ccc909/Whistler/docs/mic-array-bottom.png

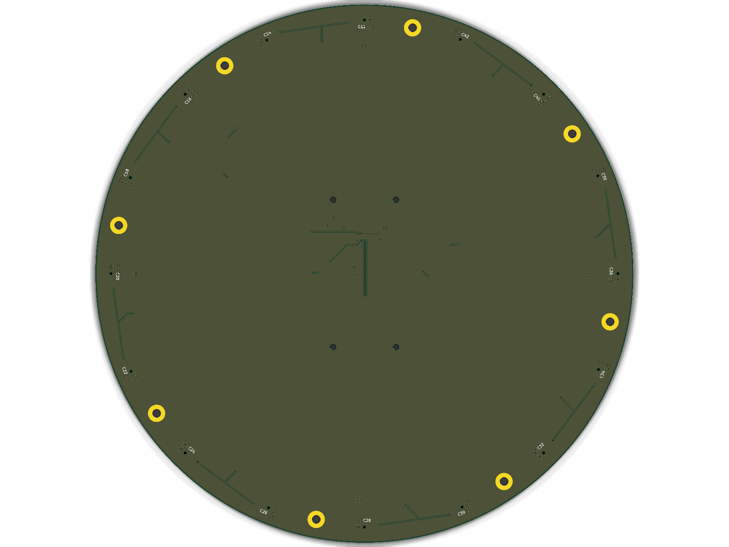
docs/mic-array-bottom.png
