ccc909/Whistler/mic-array/production/whistler-mic-array-bom.csv

Comment | Designator | Footprint | LCSC | Quantity | Manufacturer | MPN | Description
100nF | C1,C12,C14,C16,C18,C20,C22,C24,C26,C28,C30,C32,C34,C36,C38,C40,C42 | C_0402_1005Metric | C1525 | 17 |  |  | Unpolarized capacitor, small symbol
1uF | C2,C3,C4,C11,C13,C15,C17,C19,C21,C23,C25,C27,C29,C31,C33,C35,C37,C39,C41 | C_0402_1005Metric | C14445 | 19 |  |  | Unpolarized capacitor, small symbol
10uF | C5 | C_0603_1608Metric | C18800 | 1 |  |  | Unpolarized capacitor
4.7uF | C6,C7,C8,C9 | C_0603_1608Metric | C1705 | 4 |  |  | Unpolarized capacitor
LED | D2 | LED_0603_1608Metric | C12624 | 1 |  |  | Light emitting diode
680R | FB11 | C_0402_1005Metric | C96691 | 1 |  |  | Ferrite bead, small symbol
Conn_01x24 | J19 | Hirose_FH12-24S-0.5SH_1x24-1MP_P0.50mm_Horizontal | C202112 | 1 |  |  | Generic connector, single row, 01x24, script generated (kicad-library-utils/schlib/autogen/connector/)
IM72D128V01XTMA1 | MK1,MK2,MK3,MK4,MK5,MK6,MK7,MK8,MK9,MK10,MK11,MK12,MK13,MK14,MK15,MK16 | MIC_IM72D128V01XTMA1 | C5119248 | 16 | Infineon Technologies | IM72D128 | 20 Hz ~ 19 kHz Digital, PDM Microphone MEMS (Silicon) 1.62 V ~ 3.6 V Omnidirectional (-36dB ±1dB @ 94dB SPL) Solder Pads
22R | R1,R2,R3,R4 | R_0402_1005Metric | C25092 | 4 |  |  | Resistor, small symbol
470R | R5 | R_0402_1005Metric | C25117 | 1 |  |  | Resistor, small symbol
33R | R6,R7,R8,R9,R10,R11,R12,R13,R14,R15,R16,R17,R18,R19,R20,R21 | R_0402_1005Metric | C25105 | 16 |  |  | Resistor, small symbol
TPS7A2018PDBVR | U3 | SOT-23-5 | C963430 | 1 |  |  | 300 mA Low Dropout Voltage Regulator, Fixed Output, 1.6..6.0Vin, Low-Noise (7μV RMS), 6.5μA IQ LDO, SOT-23
74LVC125 | U6 | SOIC-14_3.9x8.7mm_P1.27mm | C6057 | 1 |  |  | Quad buffer 3-State outputs
