ccc909/Whistler/mic-array/production/whistler-mic-array.step

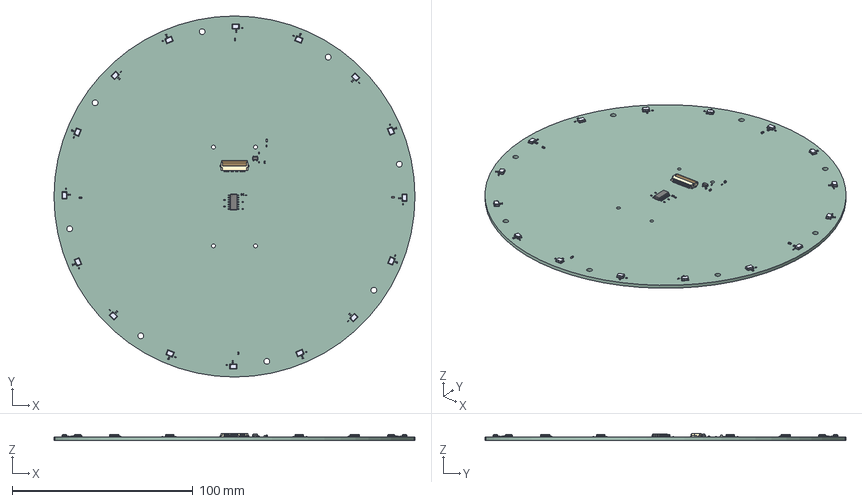
[picture p7: CAD file, 2026-10-23]
mic-array/production/whistler-mic-array.step
200.0 x 200.0 x 4.00 mm
R_0402_1005Metric x 21
IM72D128V01XTMA1 x 16
lock
pins
C_0402_1005Metric x 37
SOIC-14_3.9x8.7mm_P1.27mm
C_0603_1608Metric x 5
LED_0603_1608Metric
SOT-23-5
whistler-mic-array_PCB
