ccc909/Whistler/motherboard/production/whistler-motherboard.step

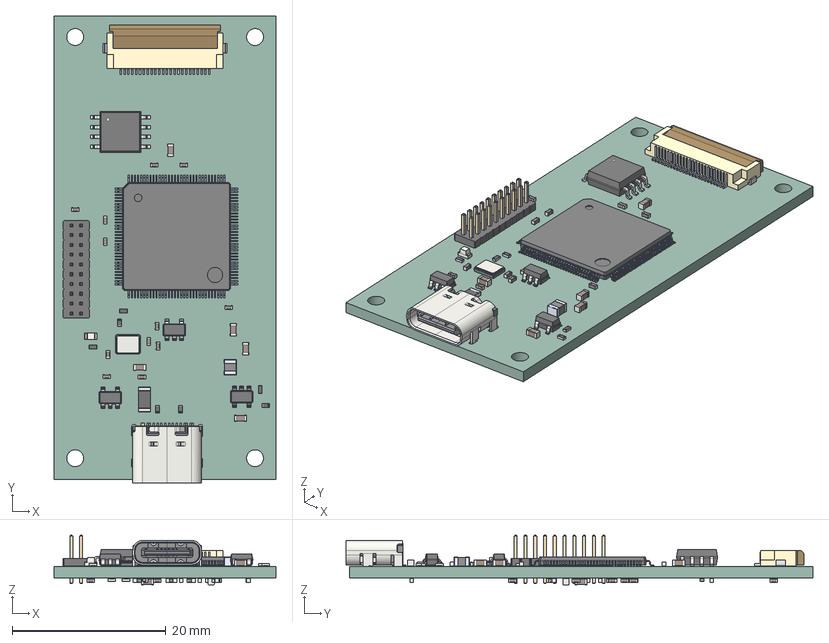
[picture p8: CAD file, 2026-10-23]
motherboard/production/whistler-motherboard.step
28.8 x 60.7 x 6.44 mm
C_0402_1005Metric x 36
R_0402_1005Metric x 10
DFE201612E-2R2M_P2
C_0603_1608Metric x 6
PinHeader_2x10_P1.27mm_Vertical
Fuse_1206_3216Metric
SOT-23-5 x 3
SOIC-8_5.3x5.3mm_P1.27mm
LED_0603_1608Metric
USB_C_Receptacle_GCT_USB4105-xx-A_16P_TopMnt_Horizontal
Body001 (Mirror #1) x 32
Body002 (Mirror #2) x 32
Crystal_SMD_3225-4Pin_3.2x2.5mm
lock
pins
L_0603_1608Metric
whistler-motherboard_PCB
