ccc909/Whistler/mic-array/production/whistler-mic-array-schematic.pdf

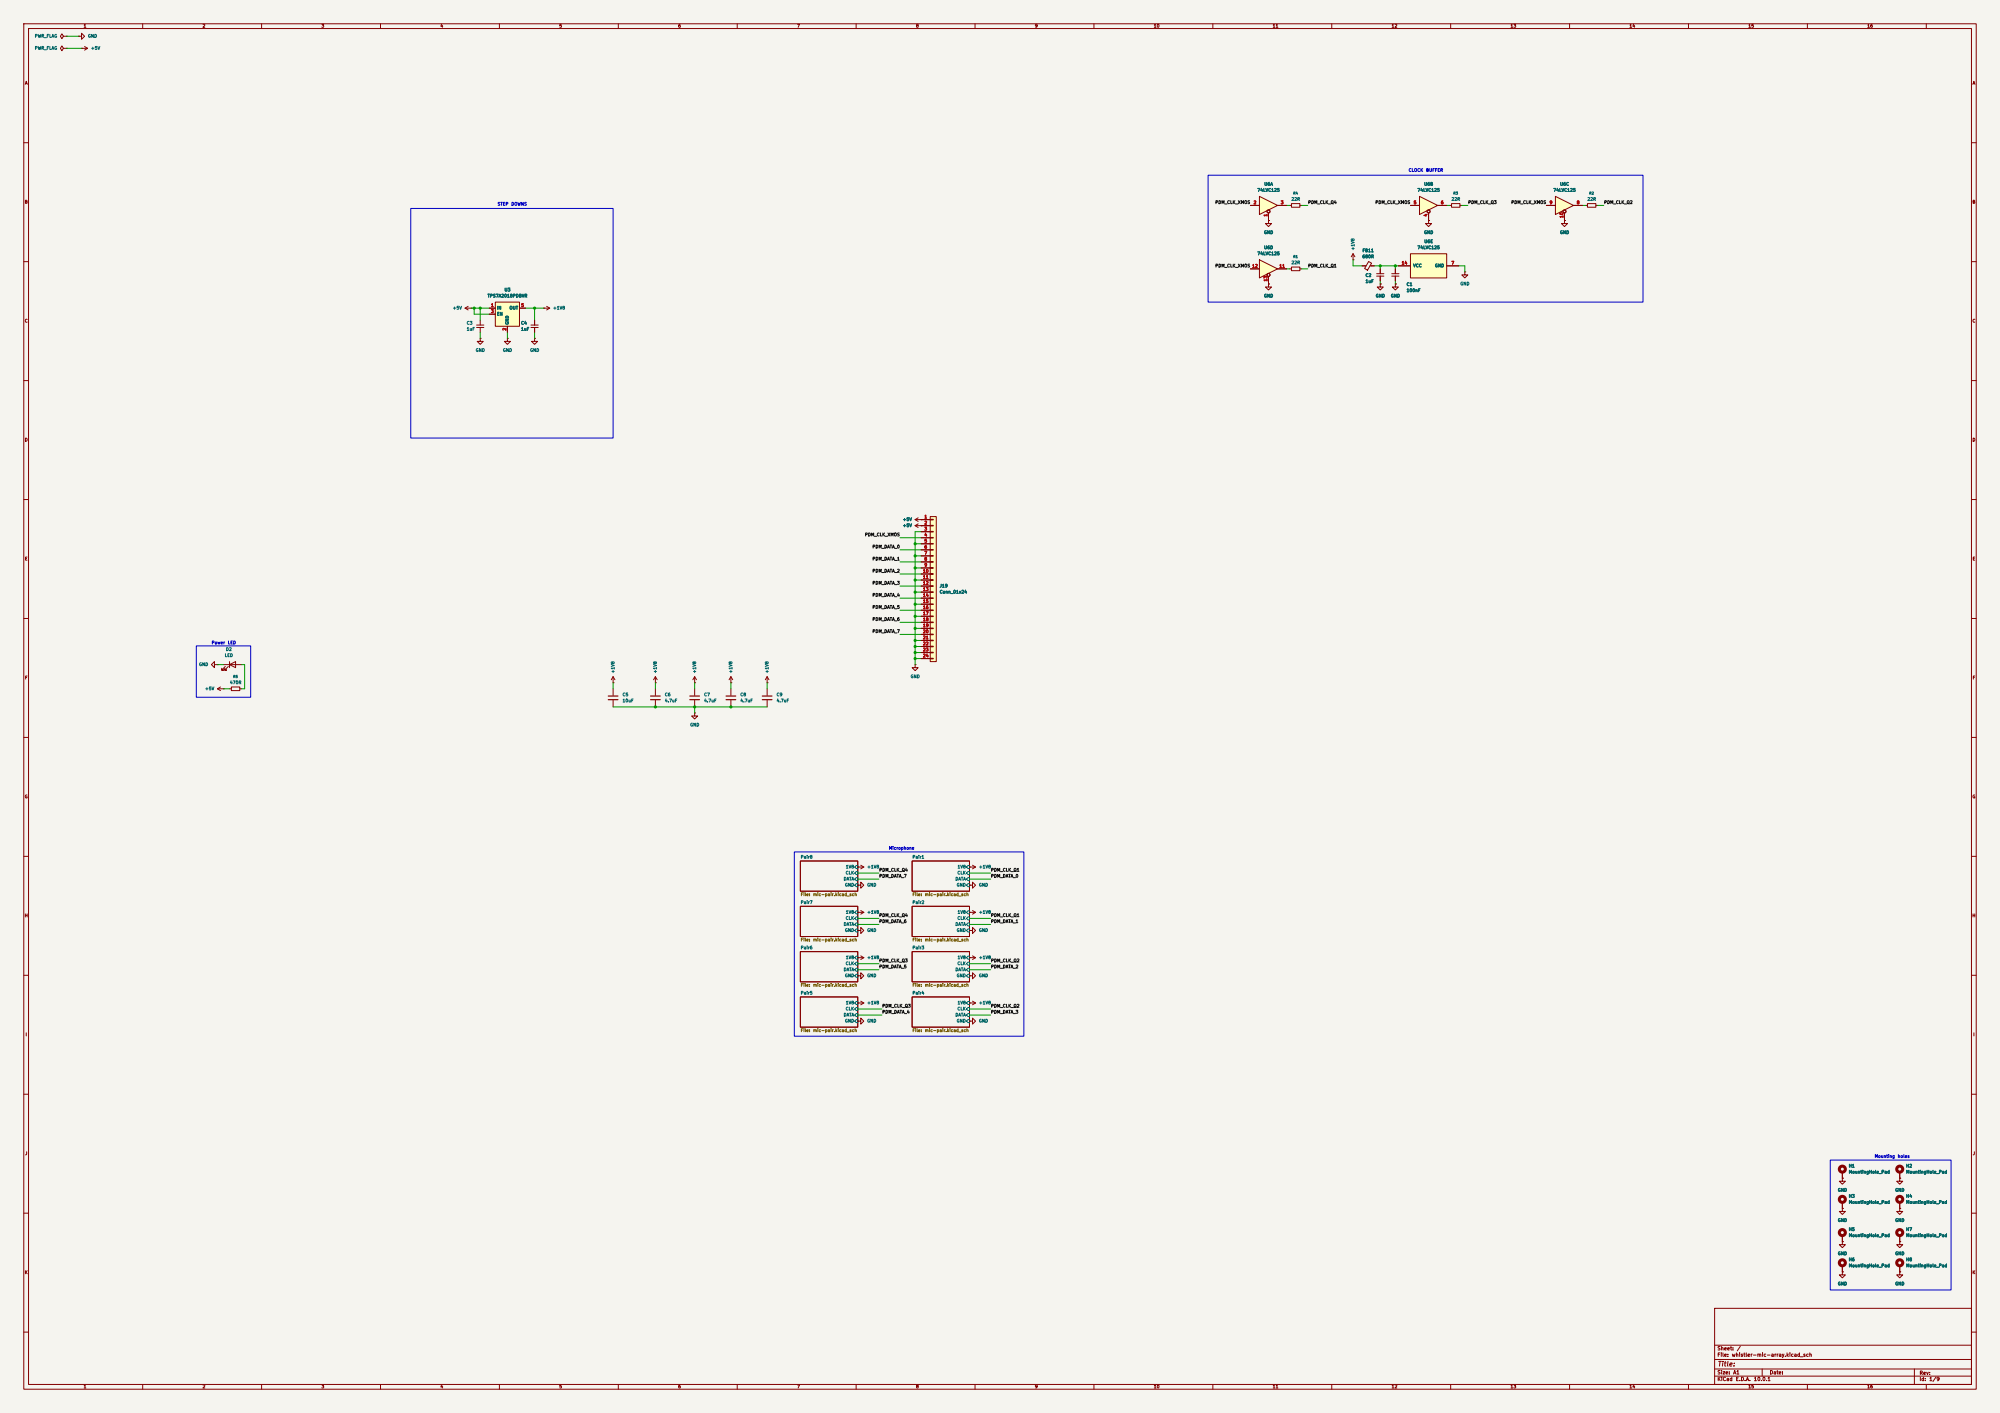
[picture p12: page 1]

File: mic-pair.kicad_sch 1V8 CLK

Pair2

Sheet: /
File: whistler-mic-array.kicad_sch
Title:

Size: A1 | Rev:
KiCad E.D.A. 10.0.1 | Id: 1/9

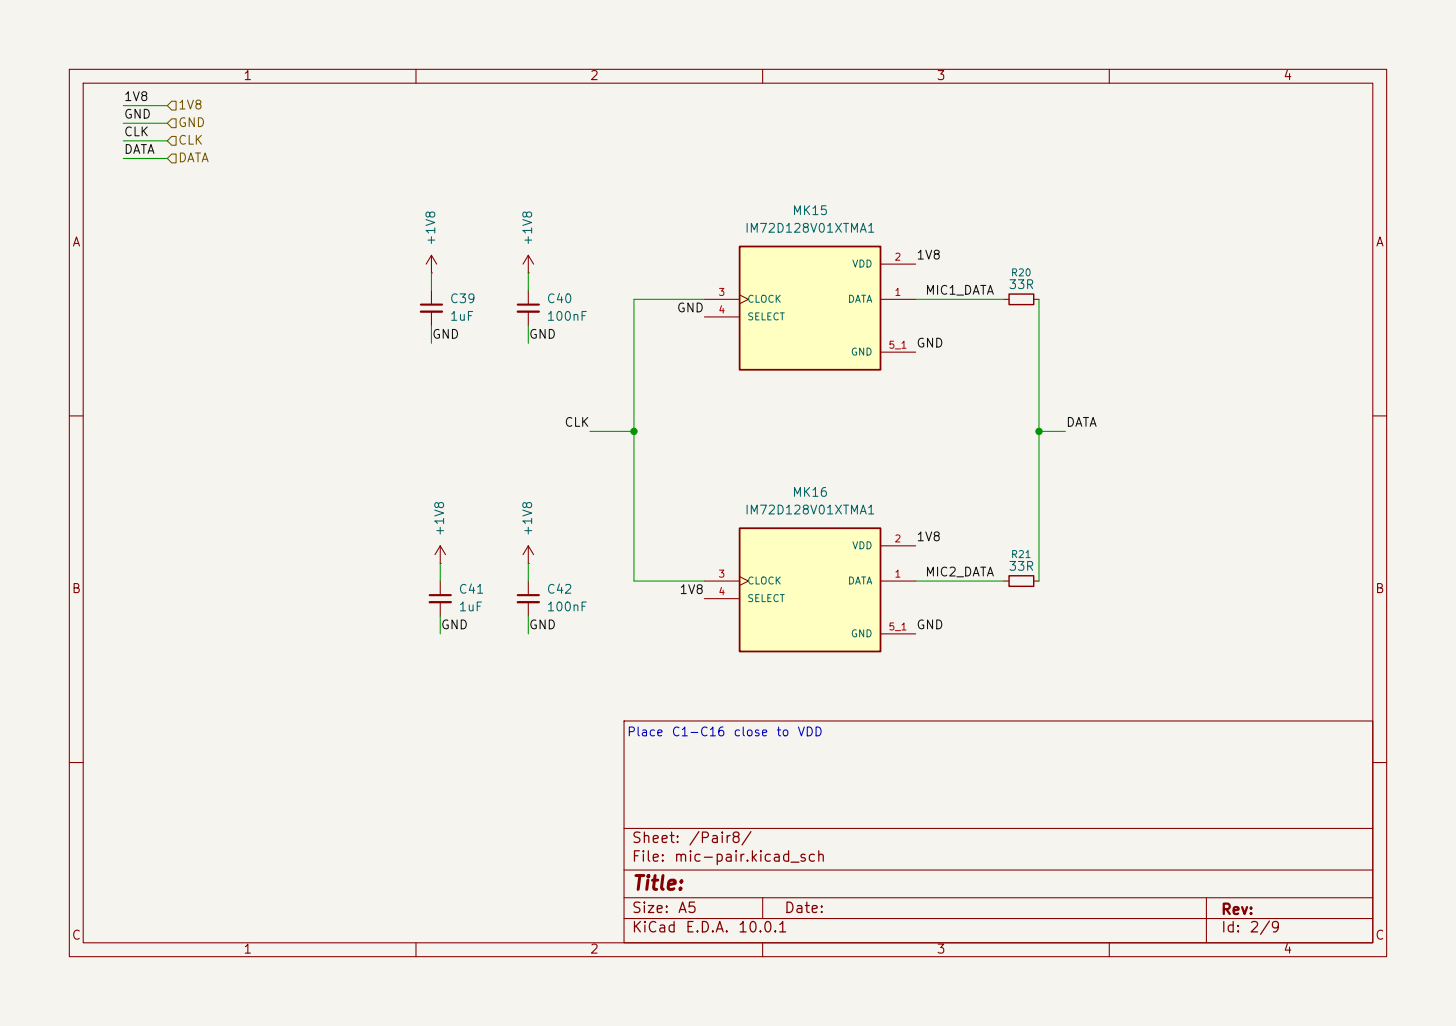
[picture p13: page 2]

1V8 Place C1-C16 close to VDD

Size: A5 | Rev: | C Date:
KiCad E.D.A. 10.0.1 | Id: 2/9

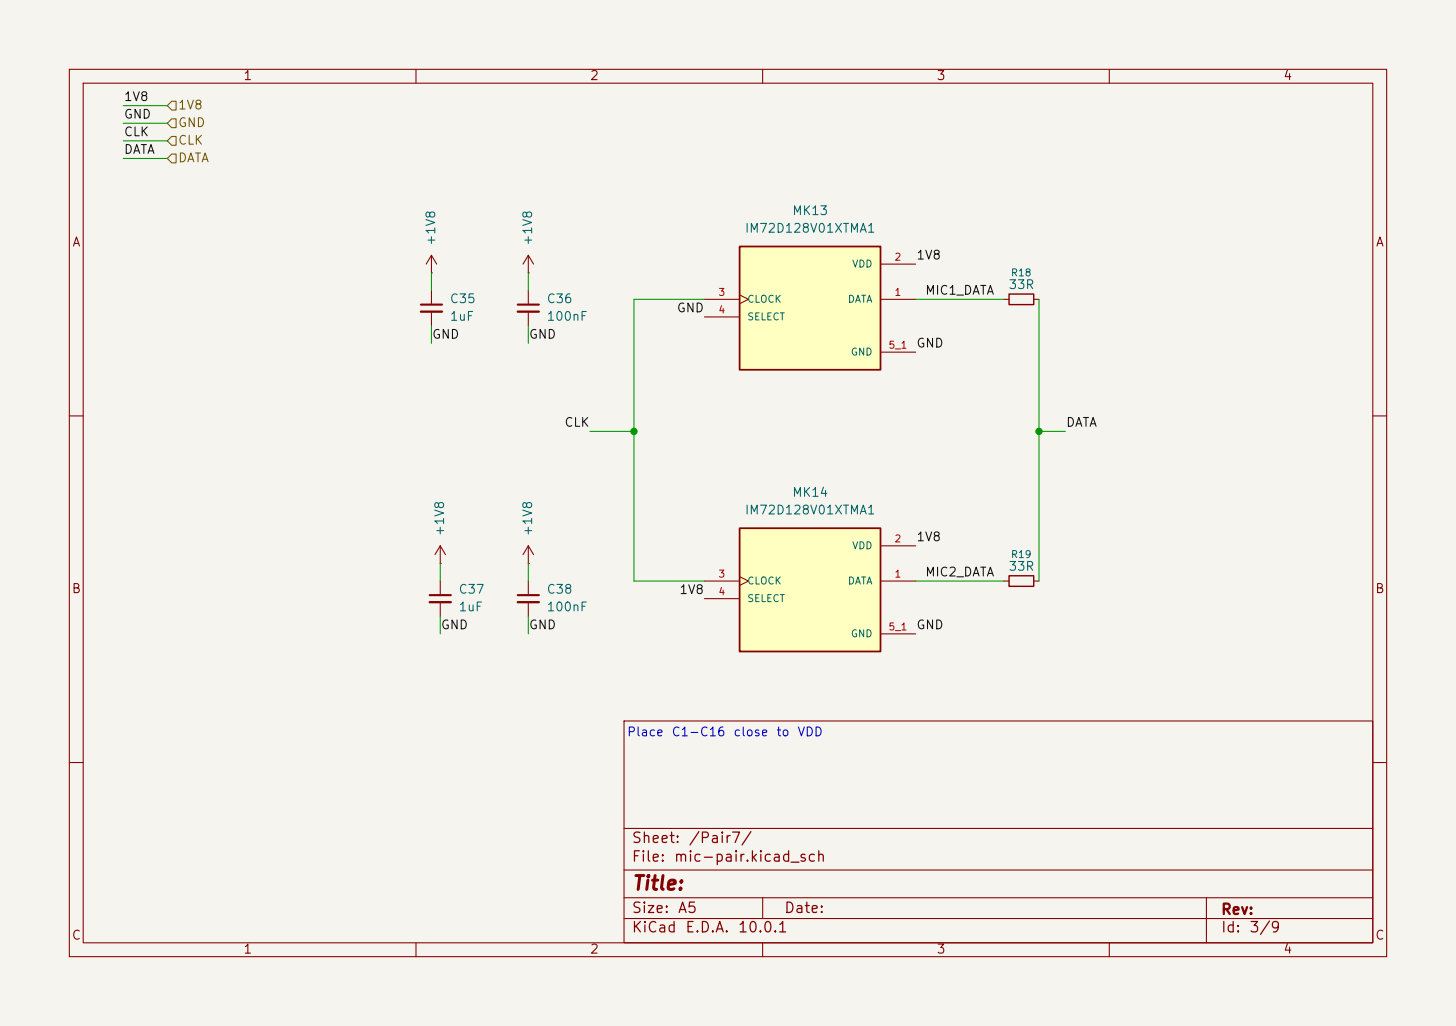
[picture p14: page 3]

1V8 Place C1-C16 close to VDD

Size: A5 | Rev: | C Date:
KiCad E.D.A. 10.0.1 | Id: 3/9

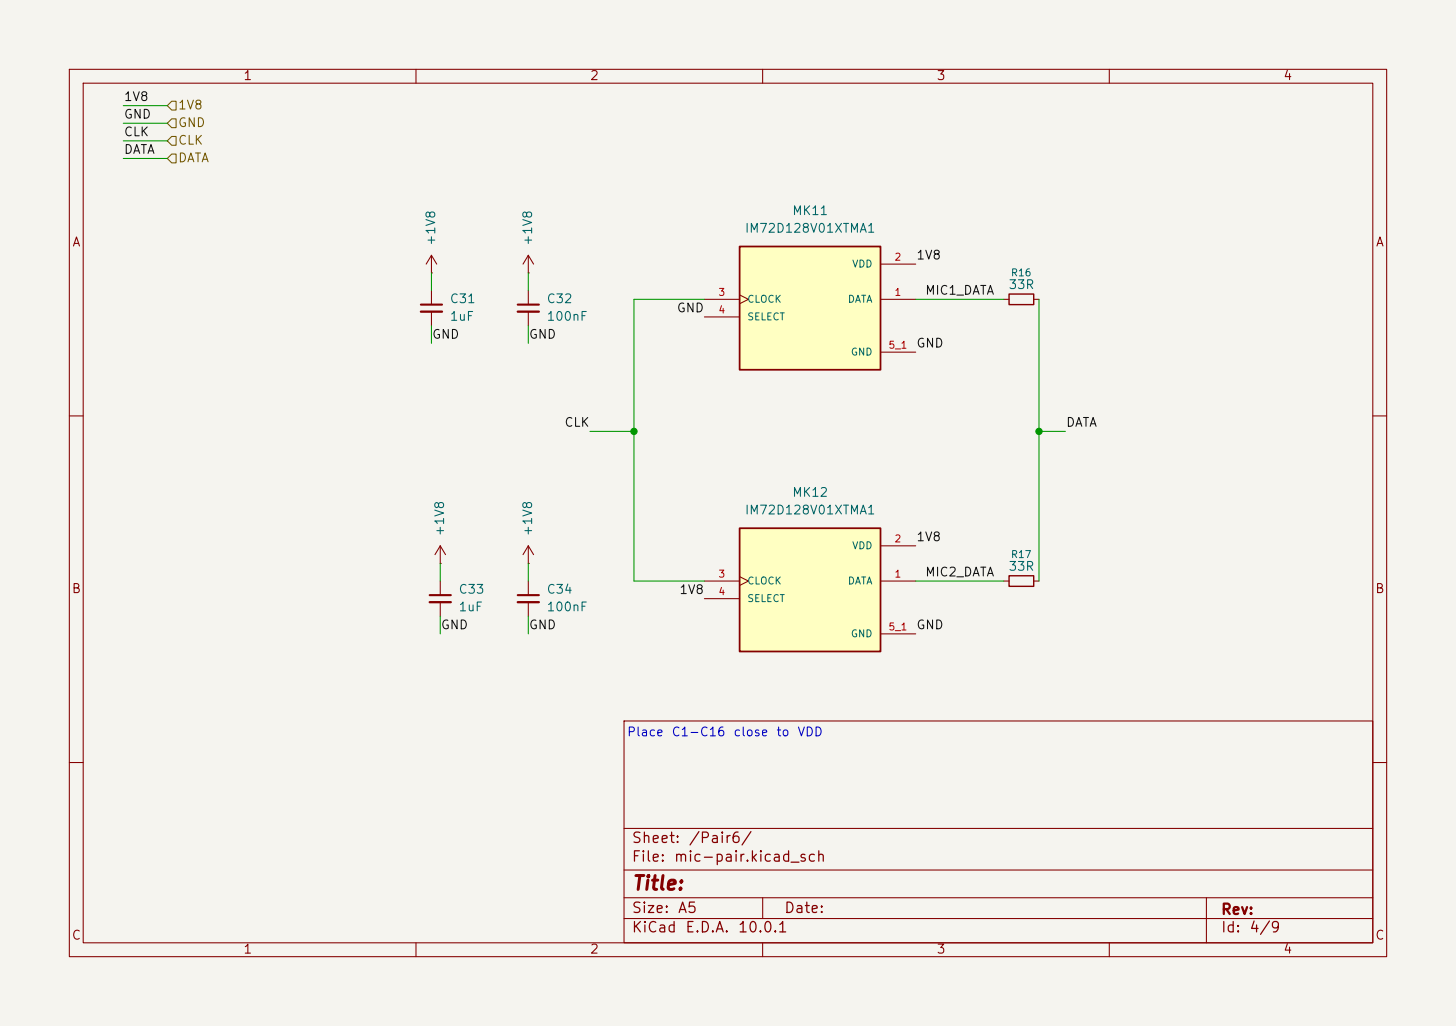
[picture p15: page 4]

1V8 Place C1-C16 close to VDD

Size: A5 | Rev: | C Date:
KiCad E.D.A. 10.0.1 | Id: 4/9

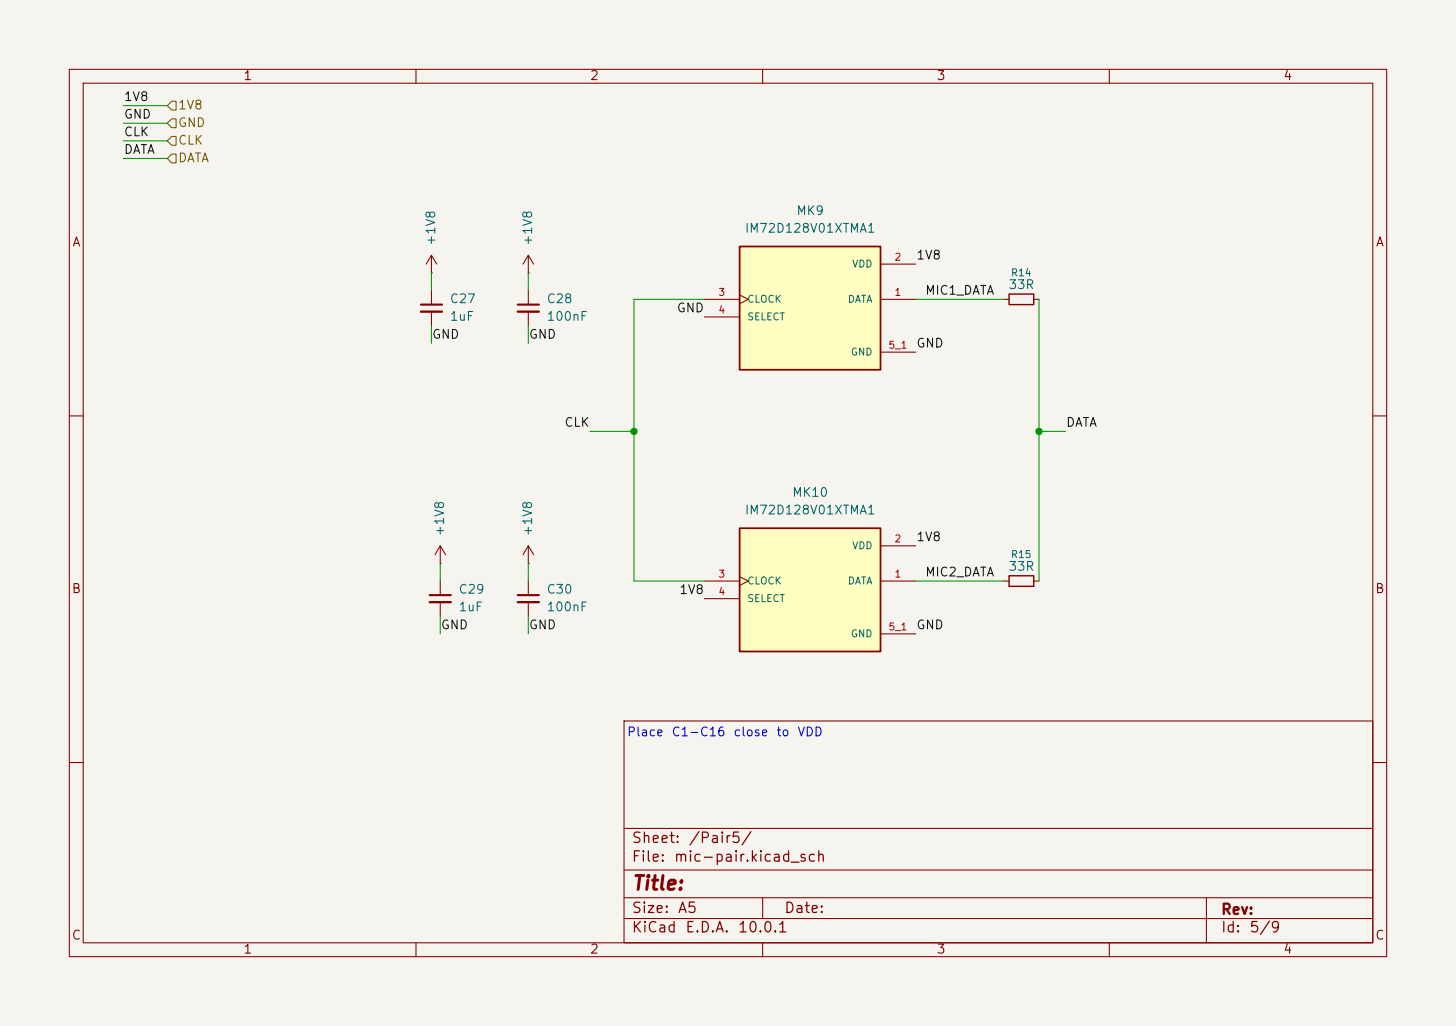
[picture p16: page 5]

1V8 Place C1-C16 close to VDD

Size: A5 | Rev: | C Date:
KiCad E.D.A. 10.0.1 | Id: 5/9

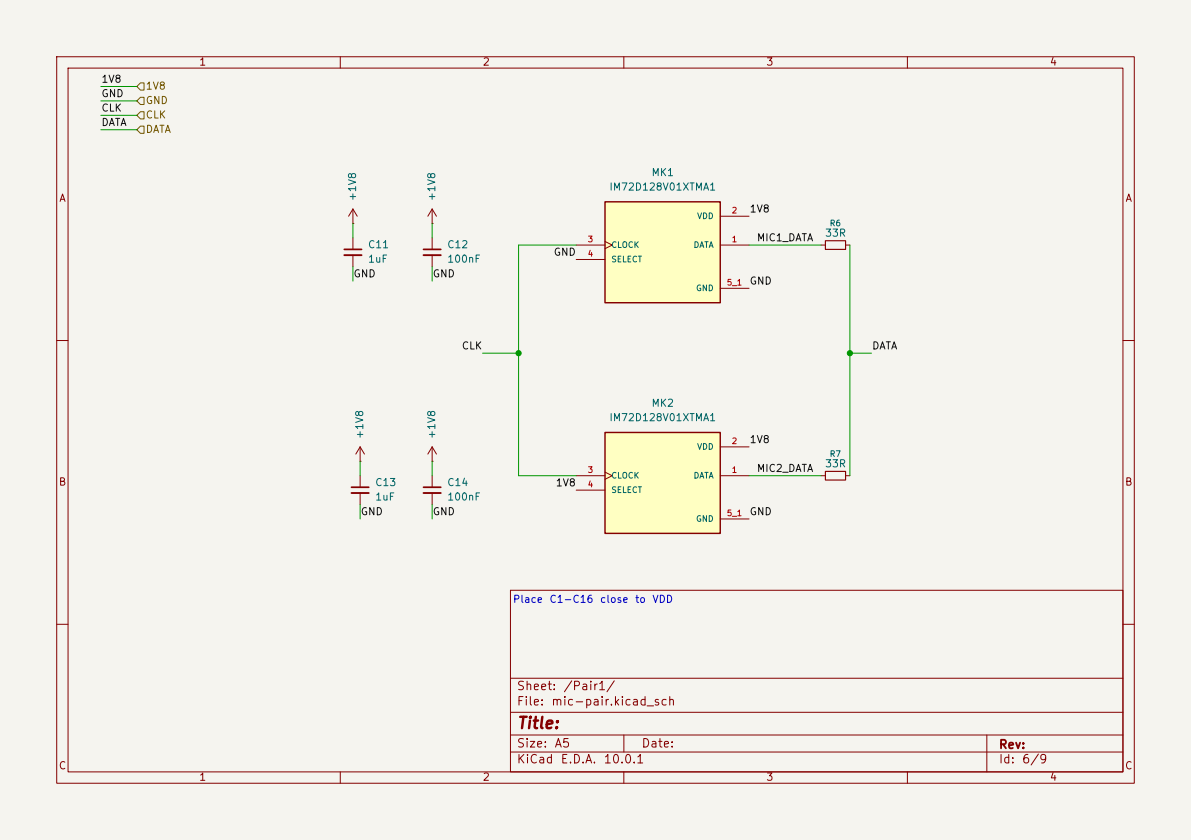
[picture p17: page 6]

1V8 Place C1-C16 close to VDD

Size: A5 | Rev: | C Date:
KiCad E.D.A. 10.0.1 | Id: 6/9

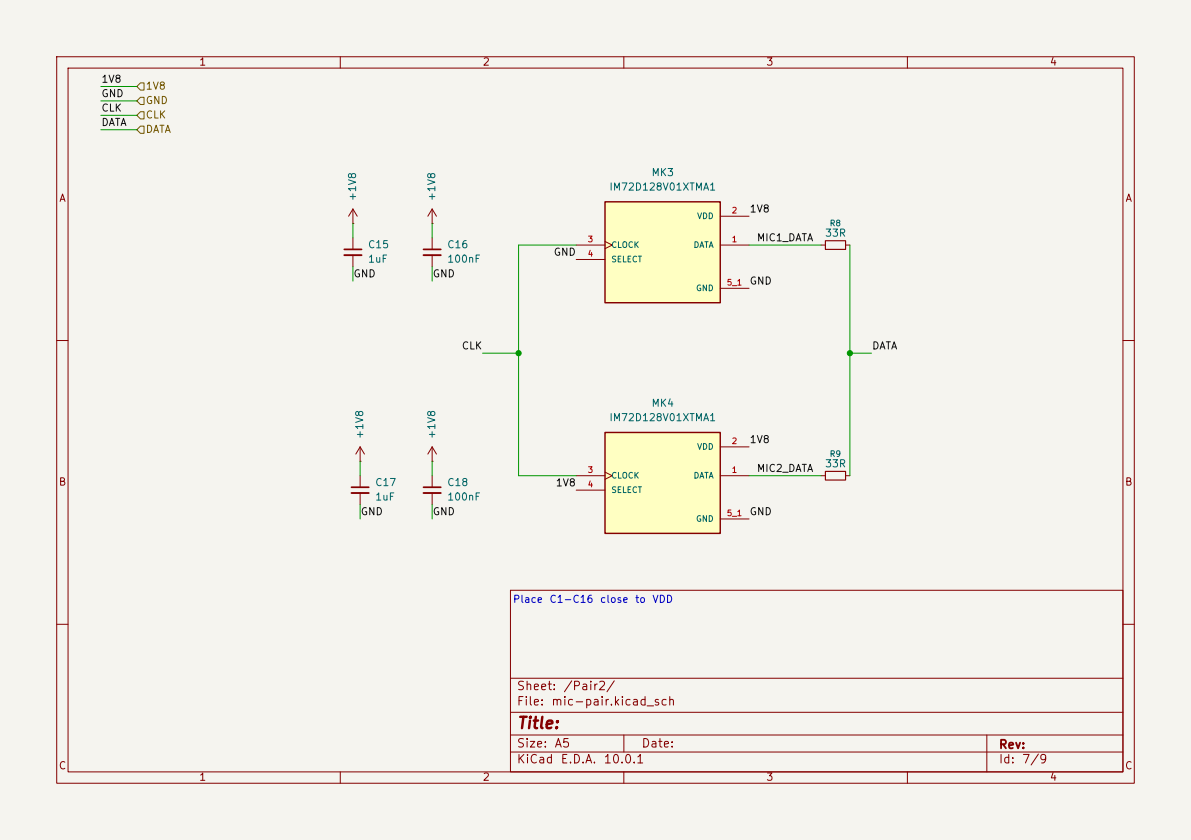
[picture p18: page 7]

1V8 Place C1-C16 close to VDD

Size: A5 | Rev: | C Date:
KiCad E.D.A. 10.0.1 | Id: 7/9

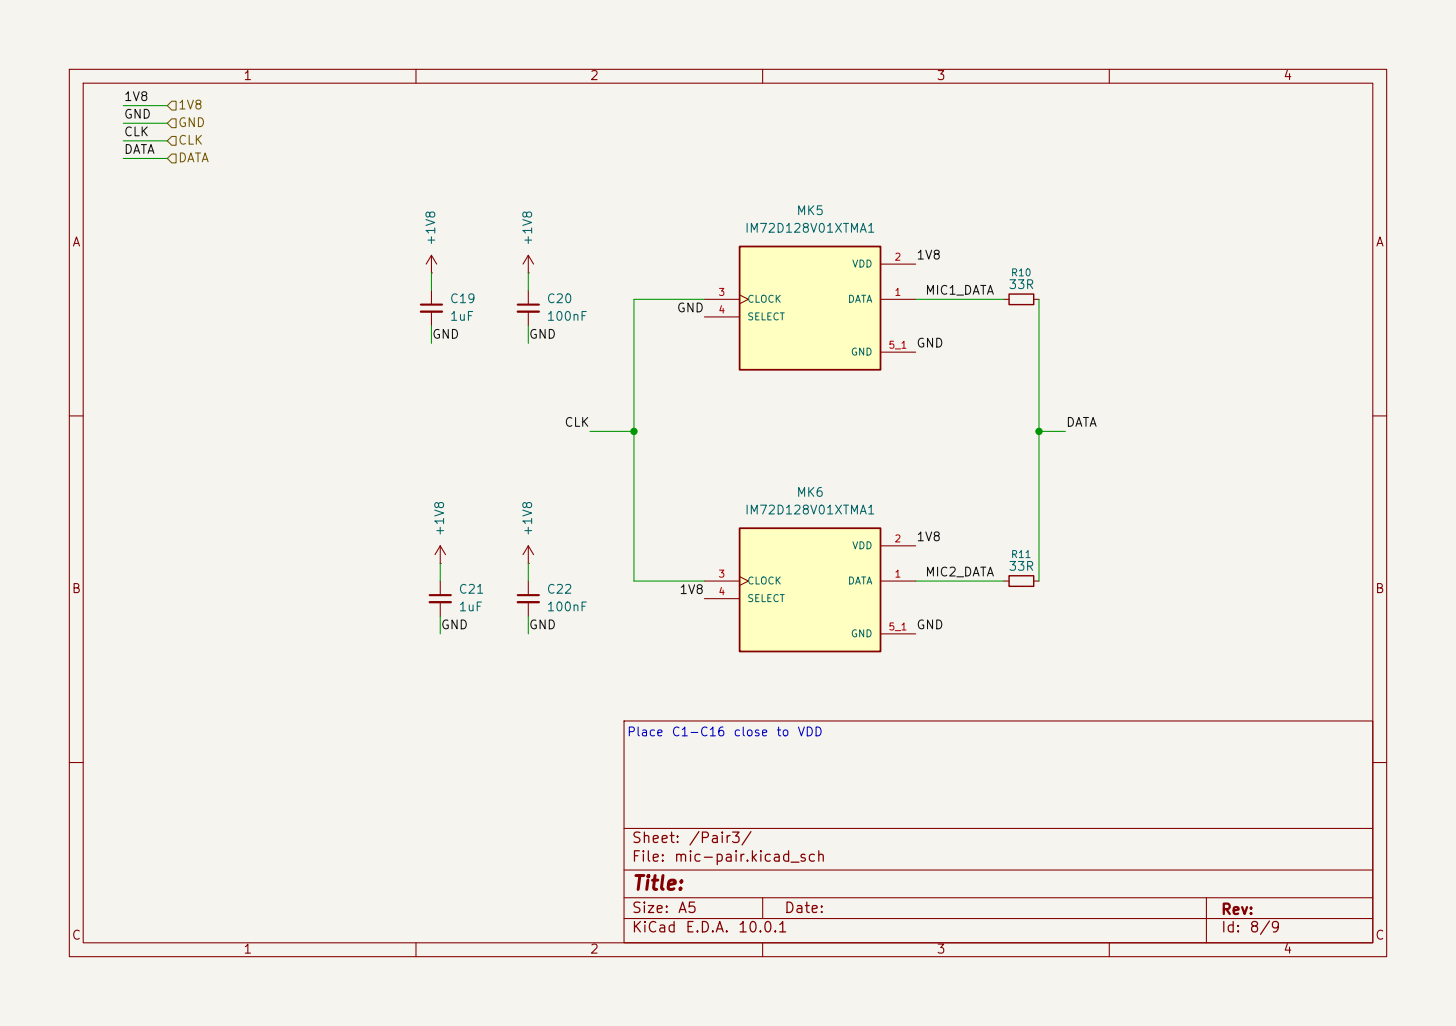
[picture p19: page 8]

1V8 Place C1-C16 close to VDD

Size: A5 | Rev: | C Date:
KiCad E.D.A. 10.0.1 | Id: 8/9

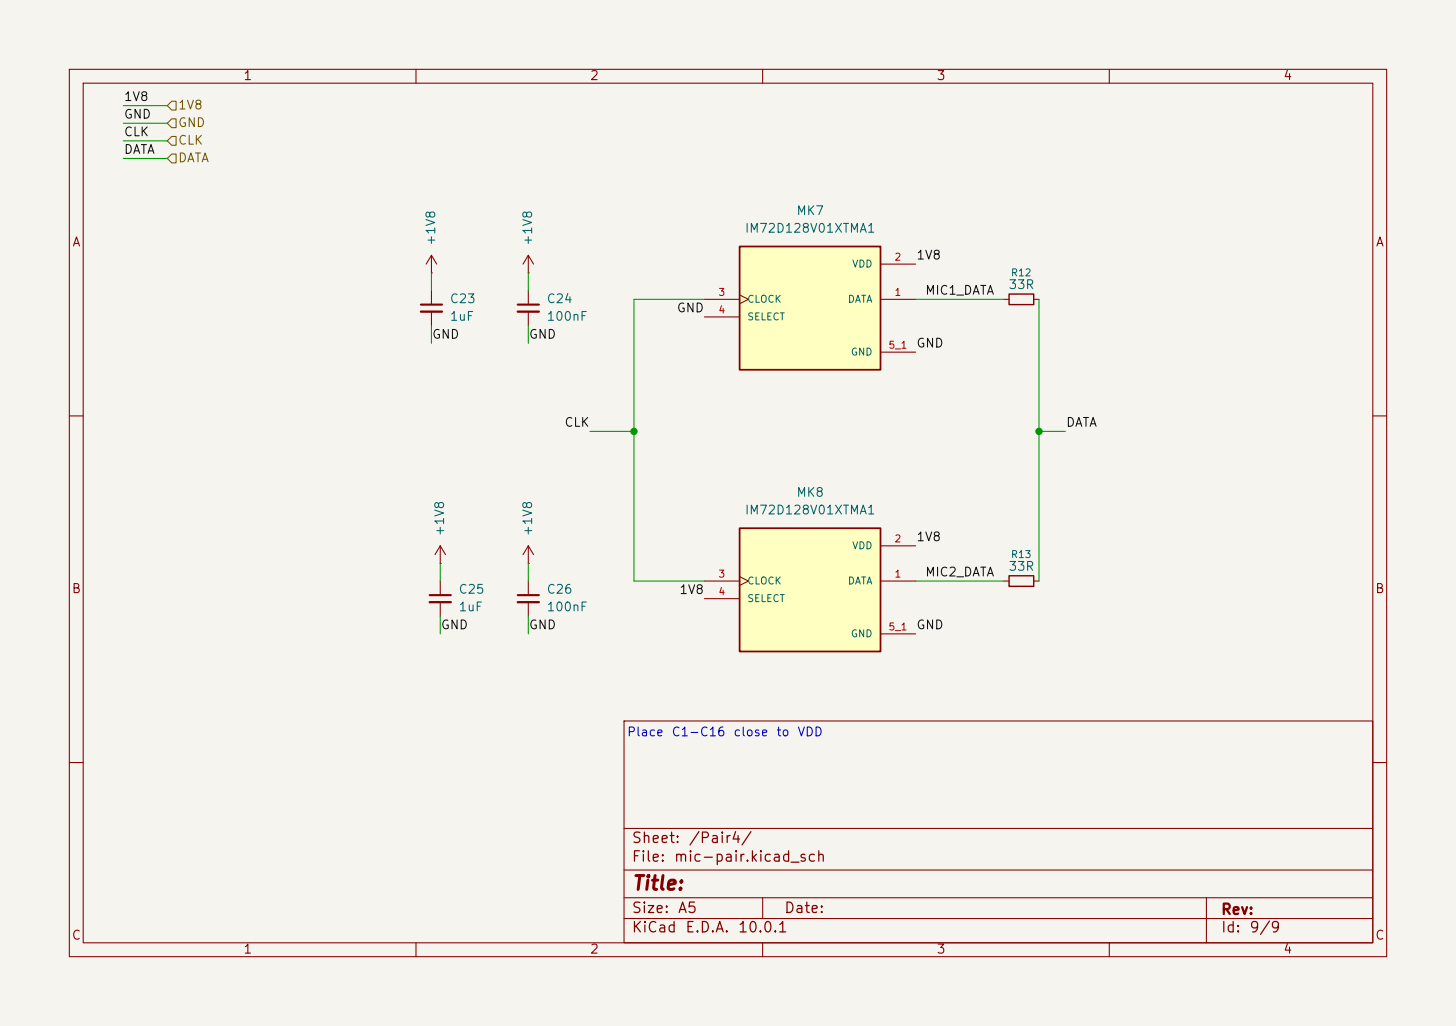
[picture p20: page 9]

1V8 Place C1-C16 close to VDD

Size: A5 | Rev: | C Date:
KiCad E.D.A. 10.0.1 | Id: 9/9
