ccc909/Whistler/motherboard/production/whistler-motherboard-schematic.pdf

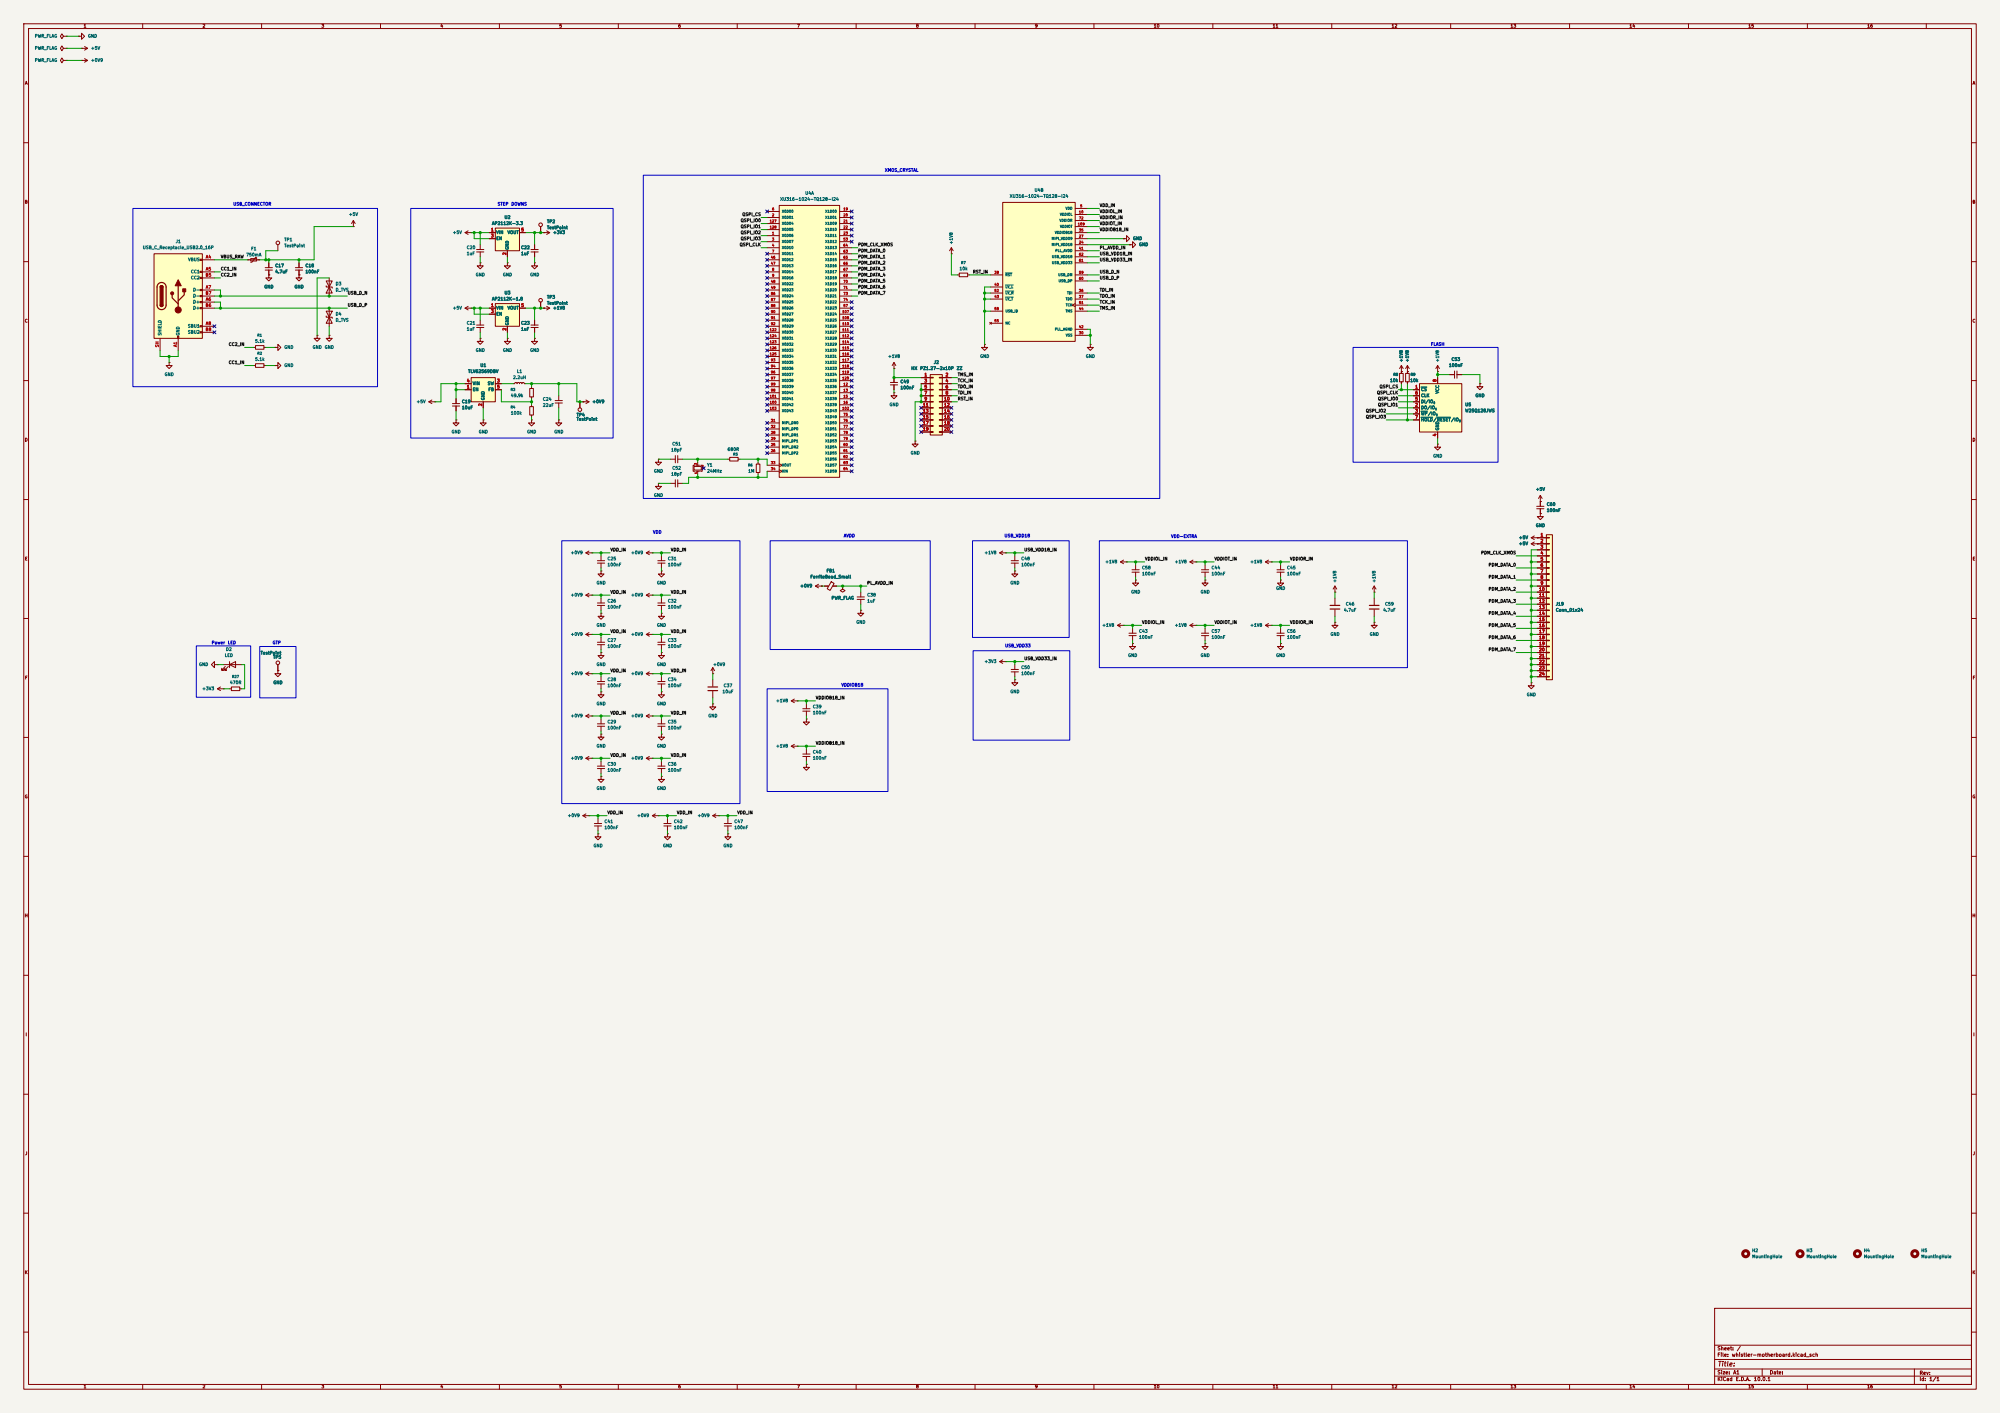
[picture p21: page 1]

7 7 | 8 8
9 9 | 10 10
11 11 | 12 12

Size: A1 | Rev:
KiCad E.D.A. 10.0.1 | Id: 1/1
