ccc909/Whistler/mic-array/whistler-mic-array.kicad_pcb

## KiCad design mic-array/whistler-mic-array.kicad_pcb (2026-10-23)

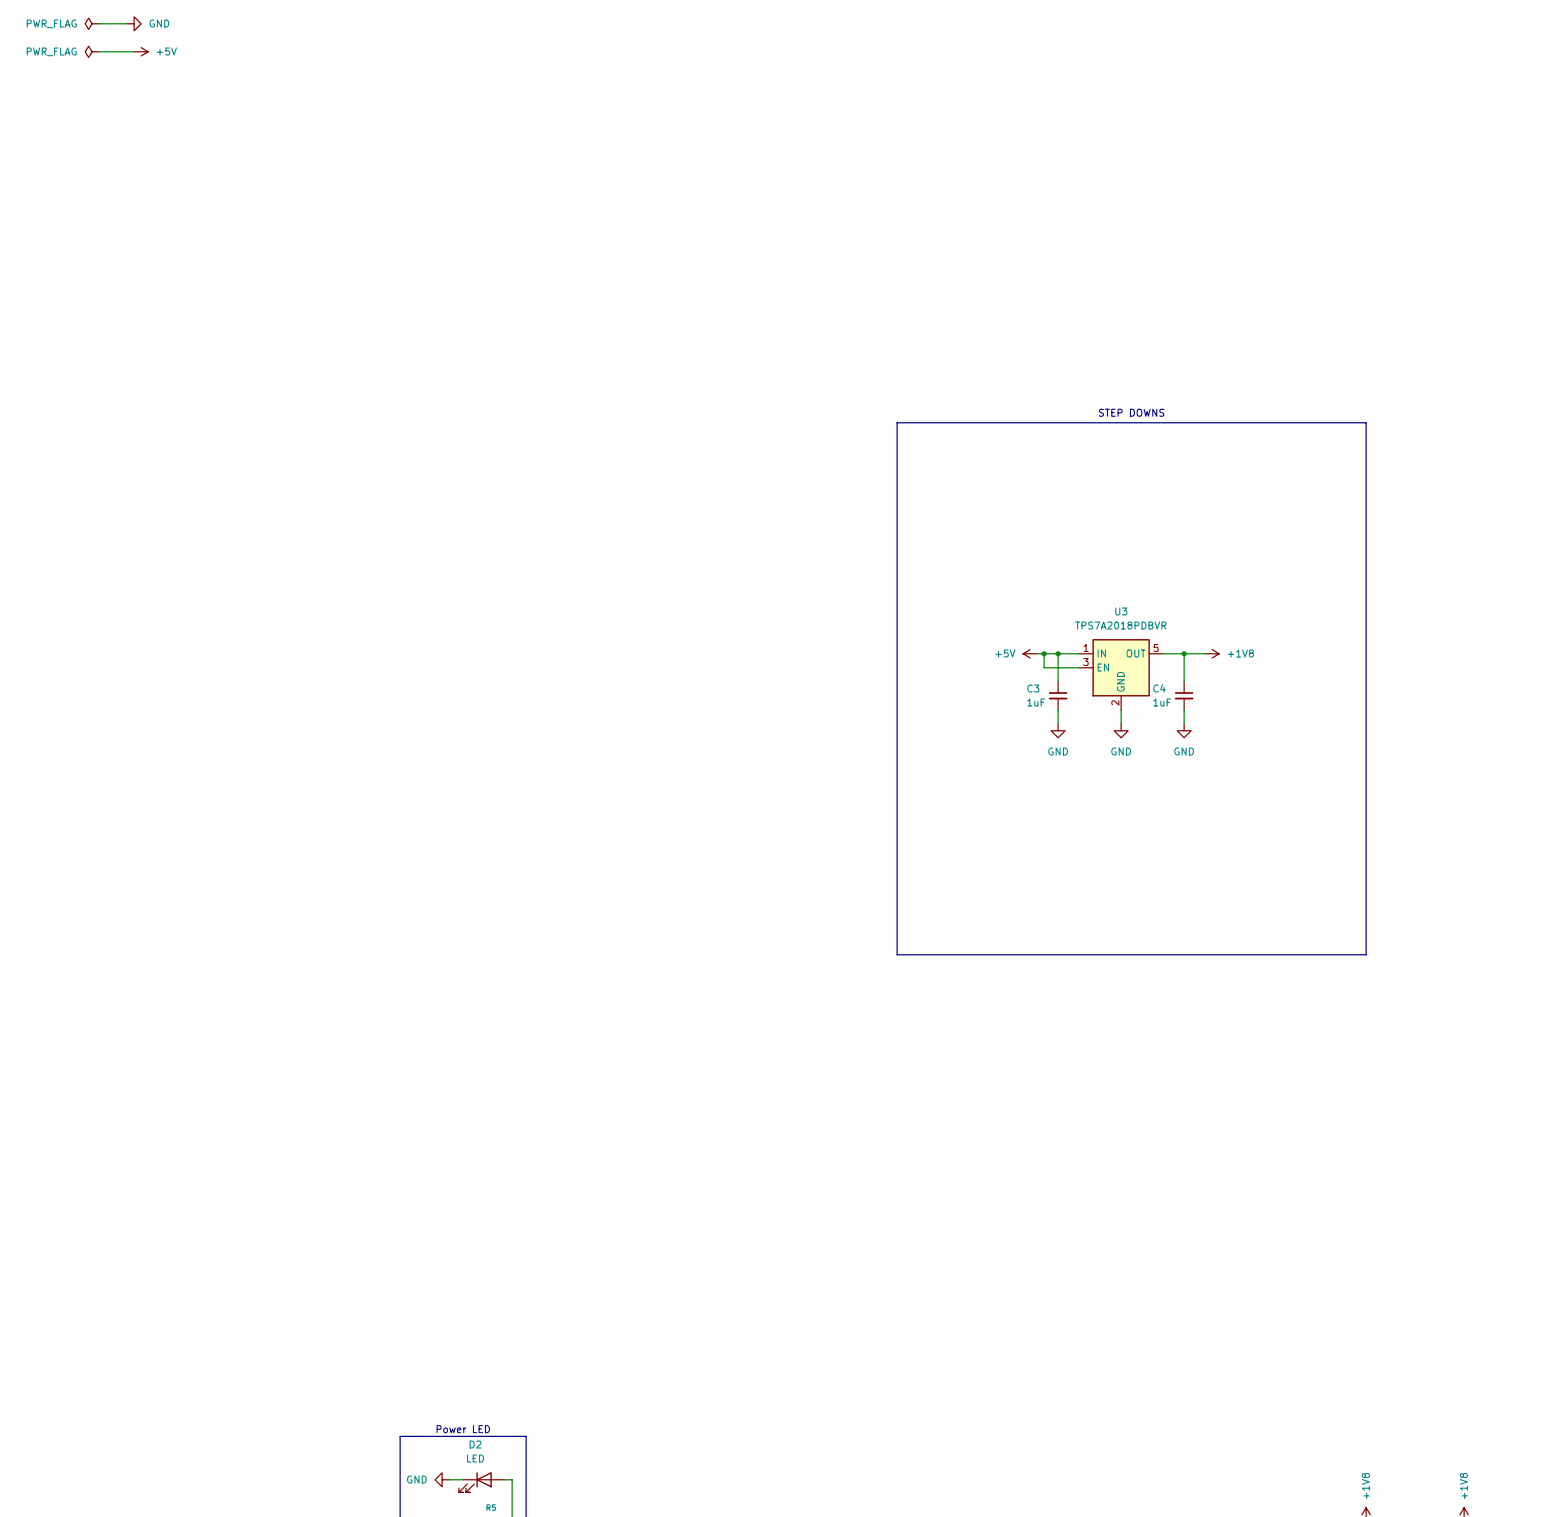
[picture p22: schematic whistler-mic-array.kicad_sch, part in row 1, column 1]

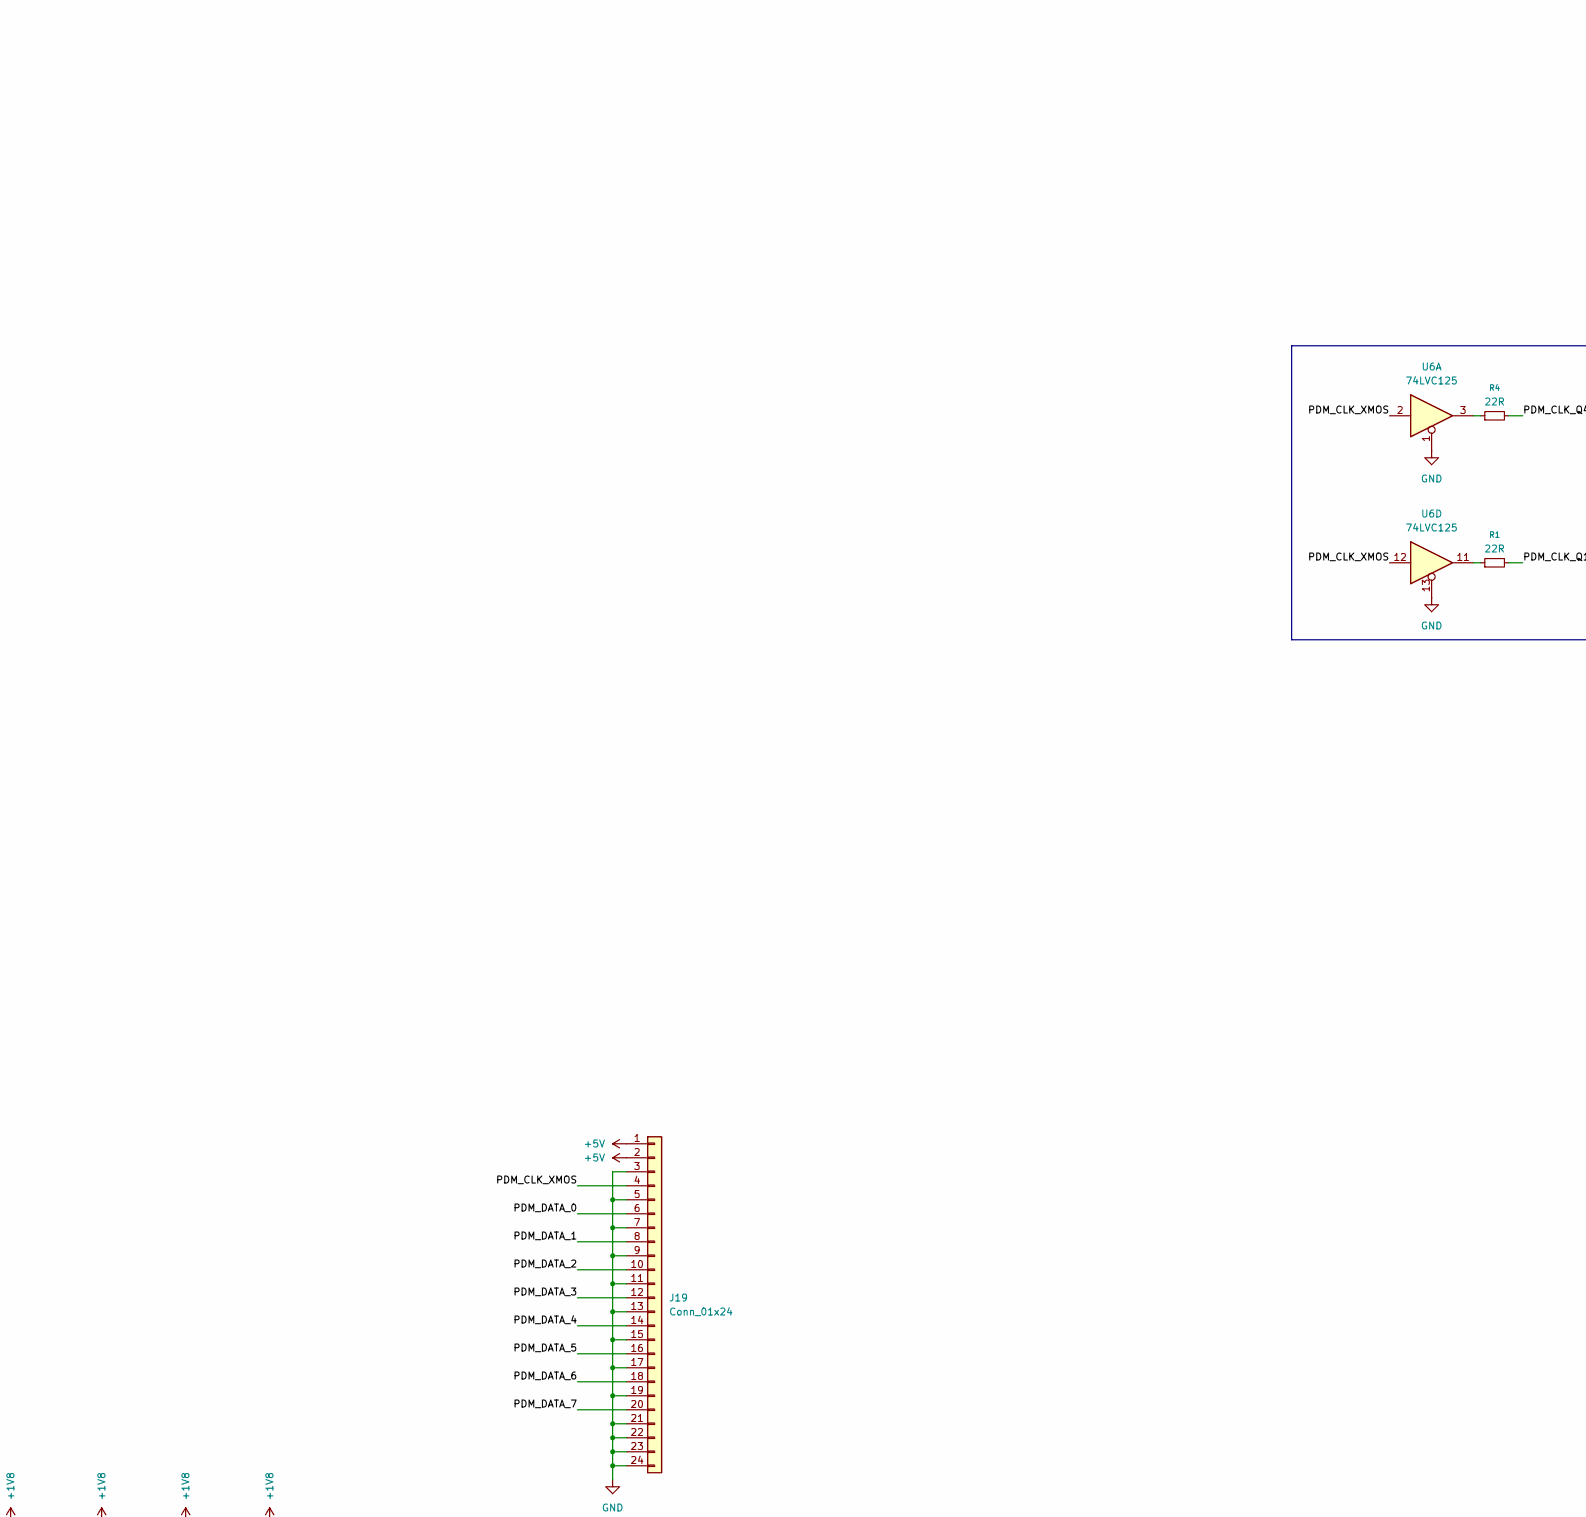
[picture p23: schematic whistler-mic-array.kicad_sch, part in row 1, column 2]

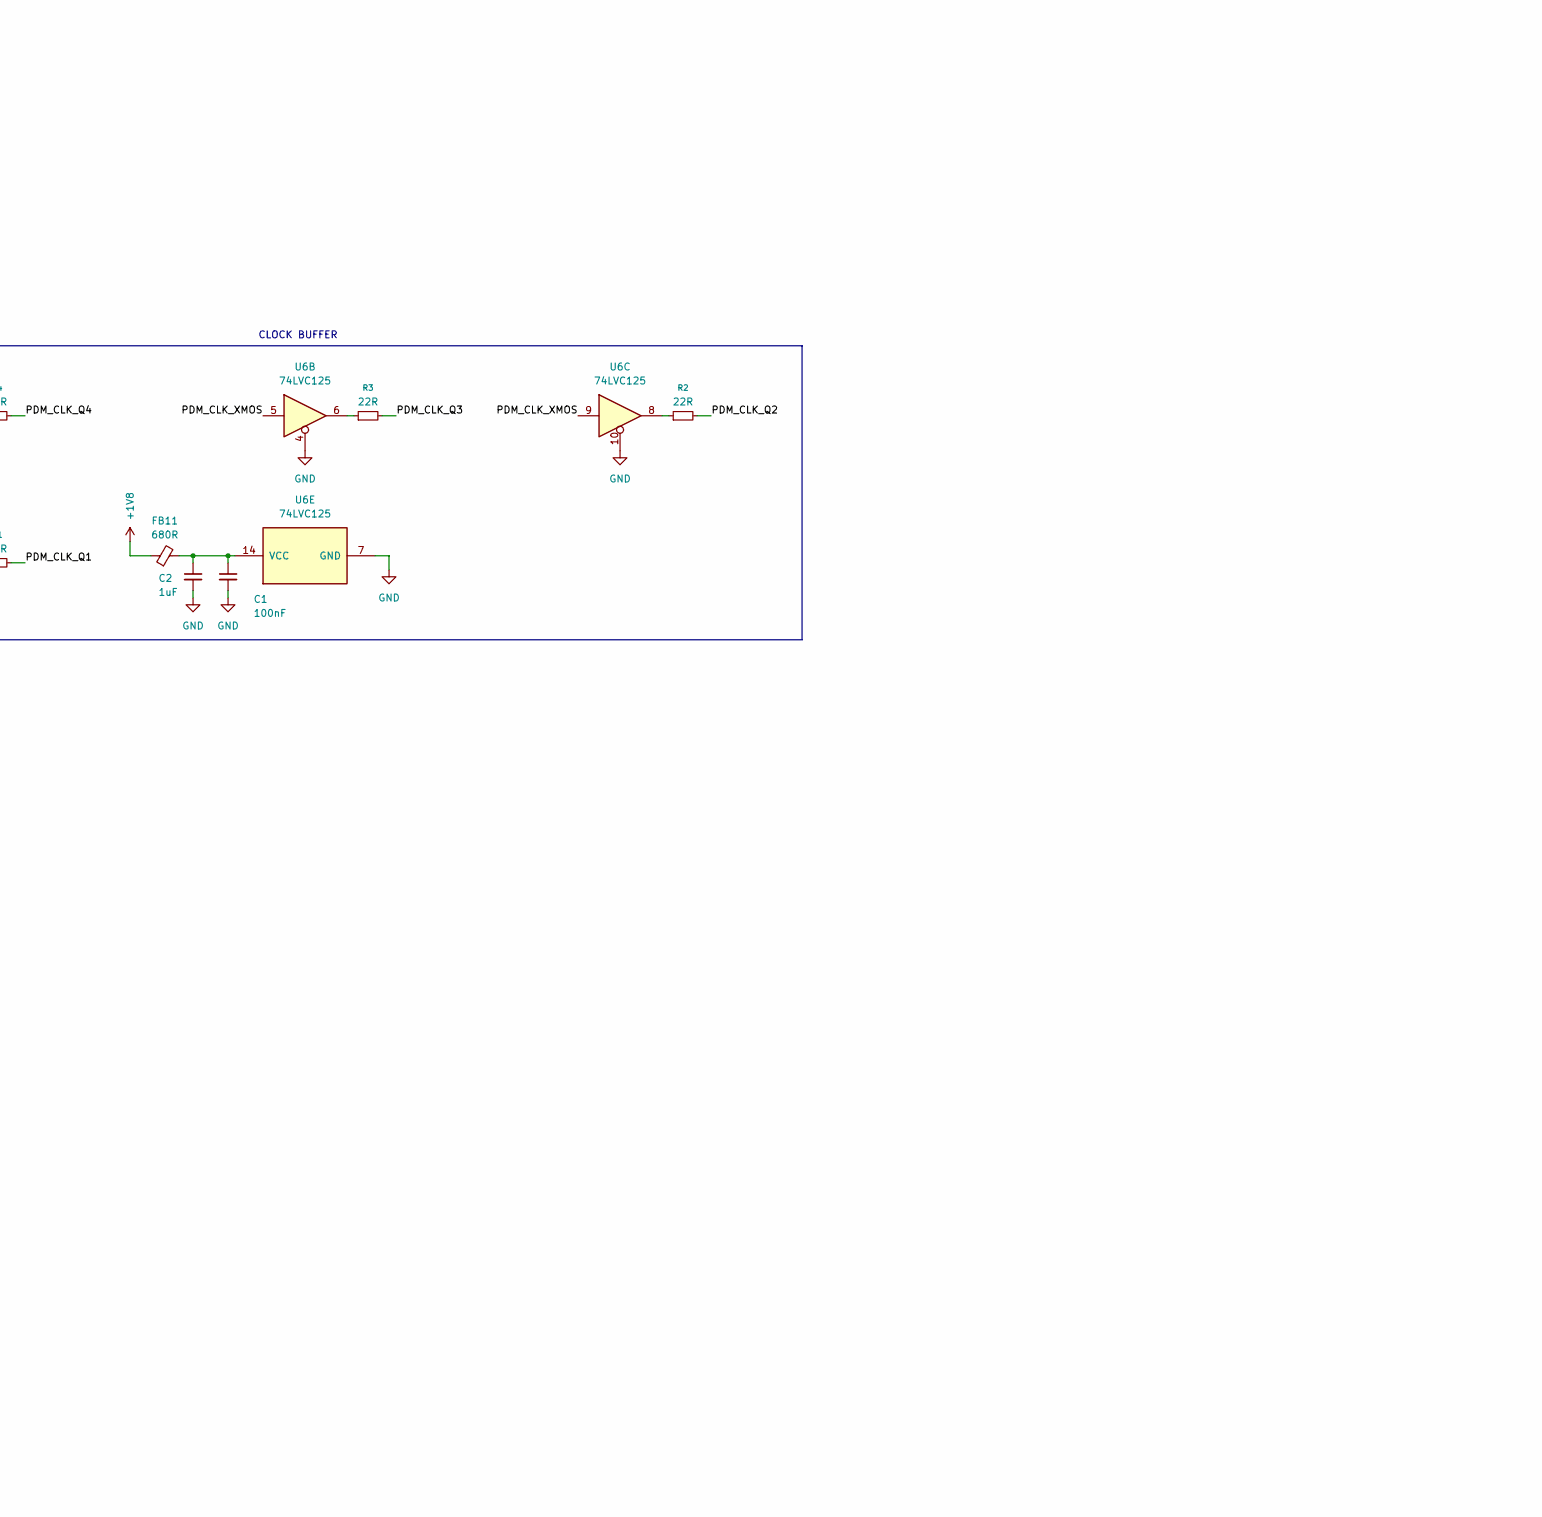
[picture p24: schematic whistler-mic-array.kicad_sch, part in row 1, column 3]

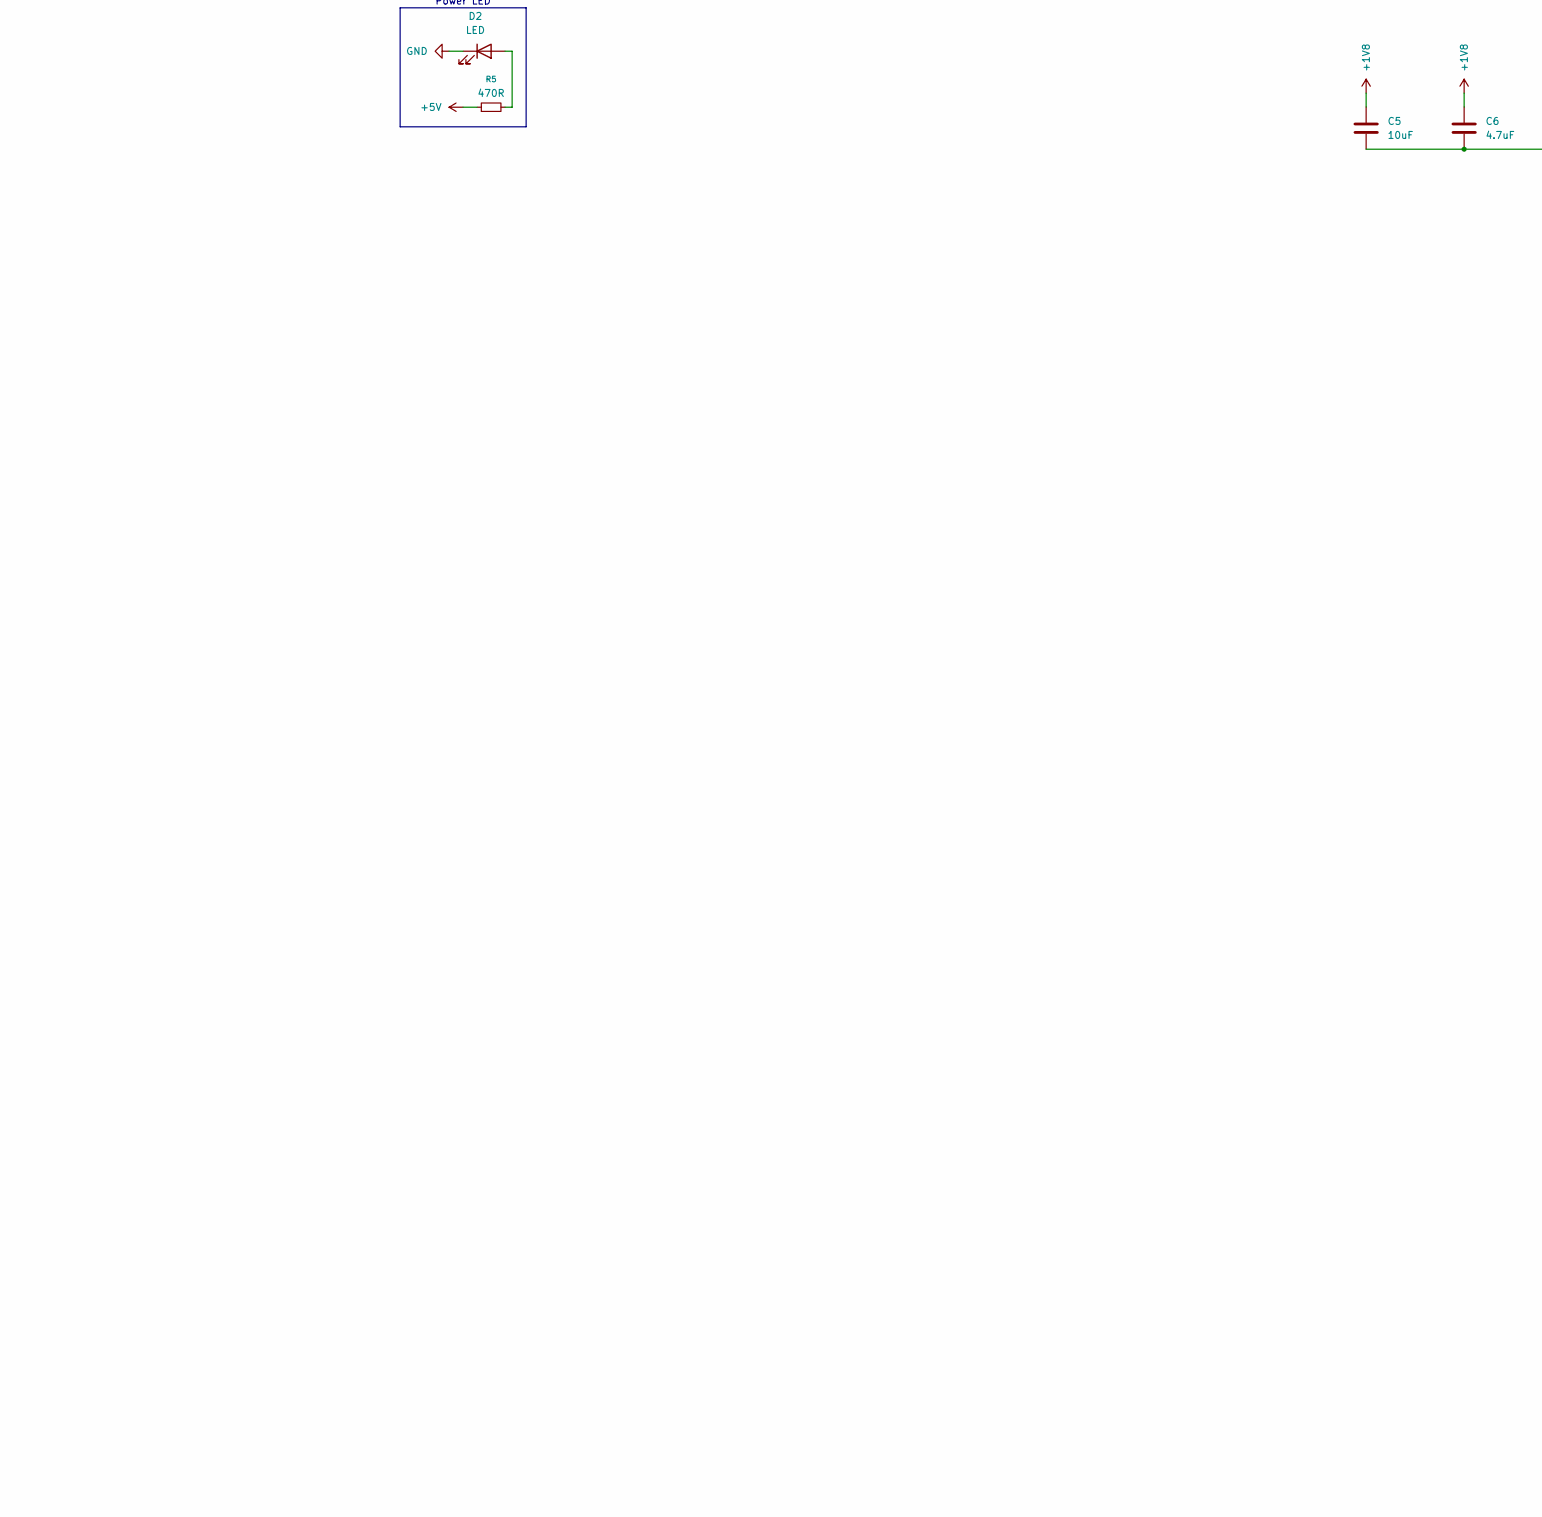
[picture p25: schematic whistler-mic-array.kicad_sch, part in row 2, column 1]

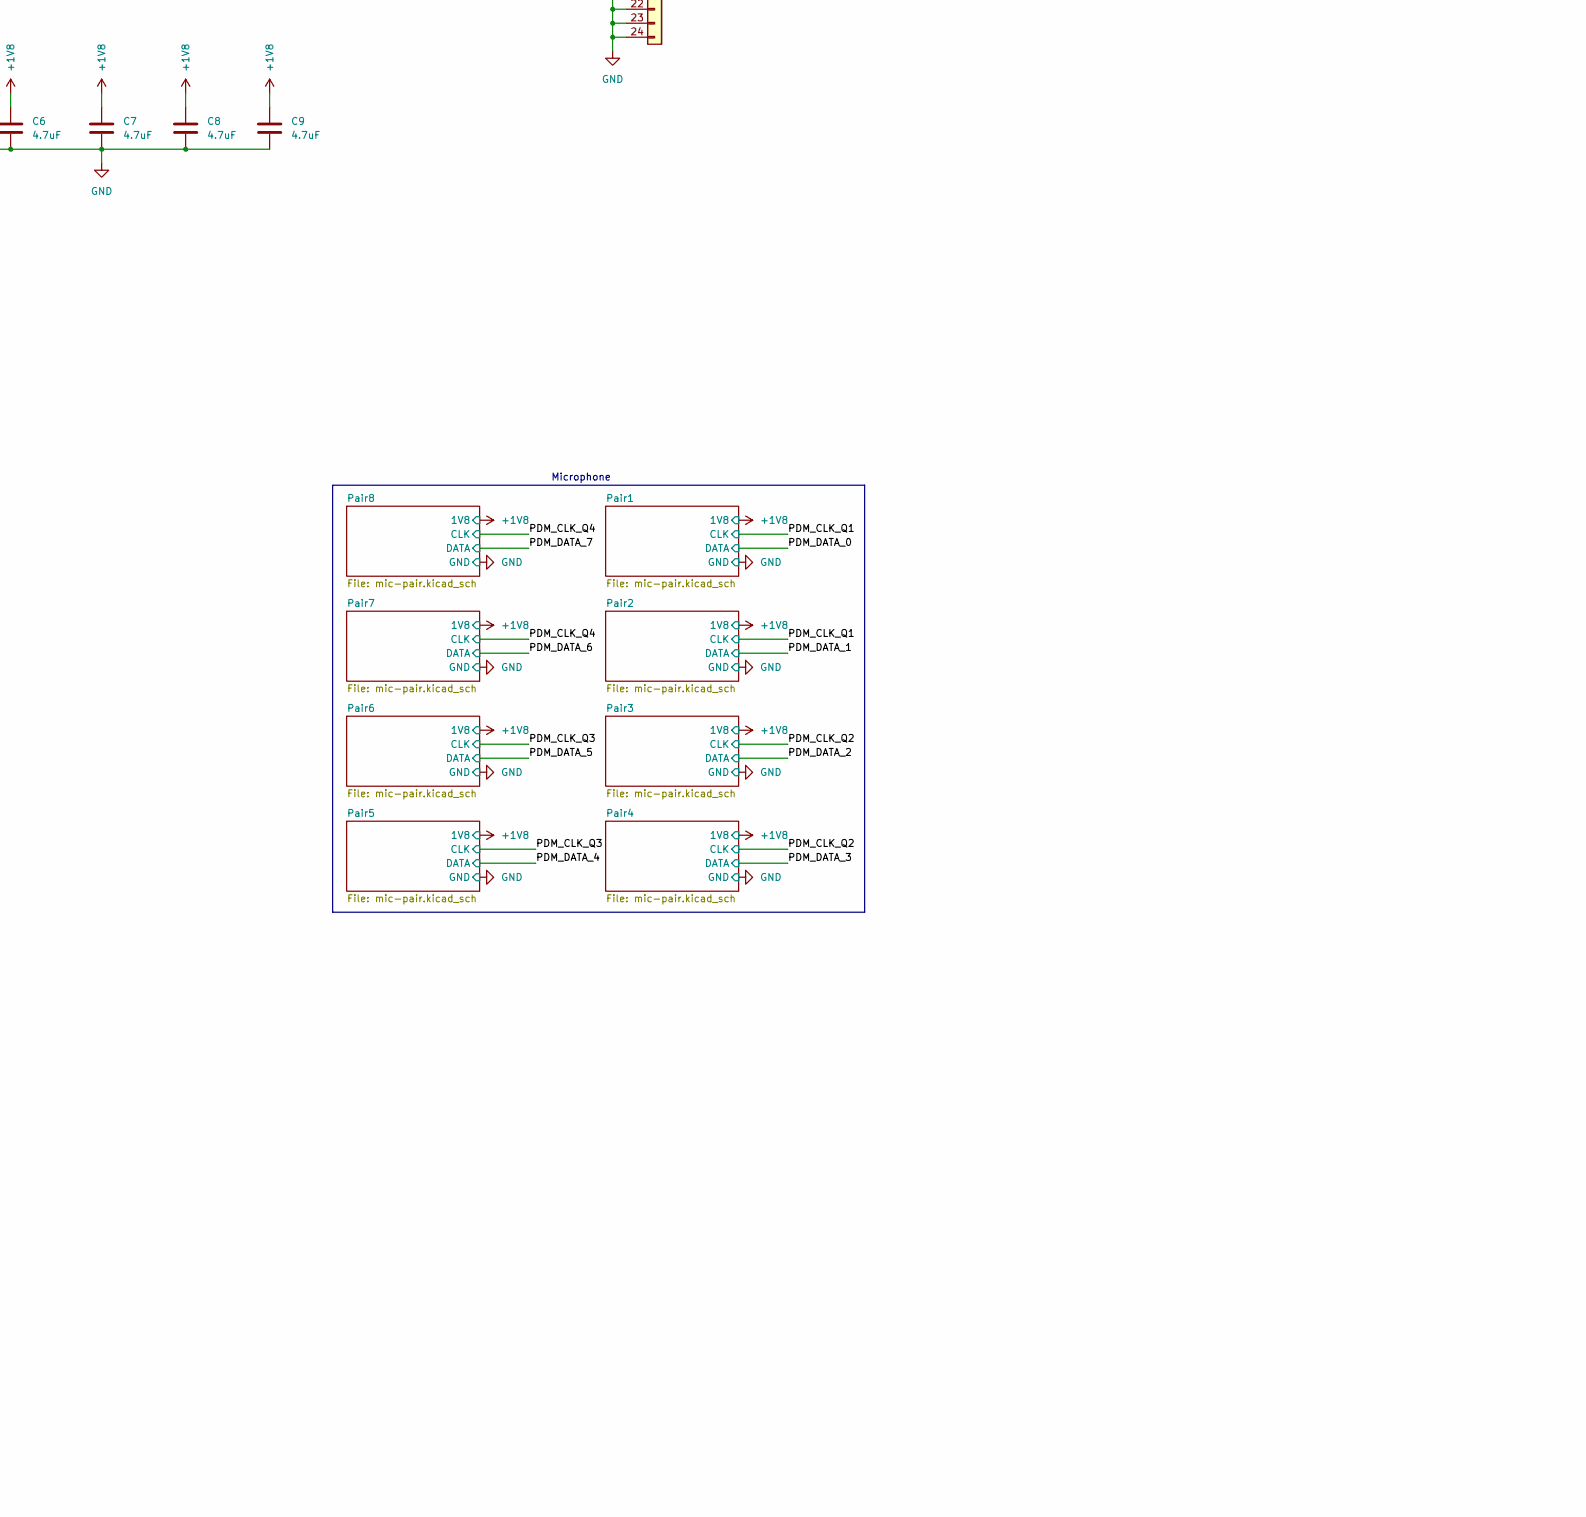
[picture p26: schematic whistler-mic-array.kicad_sch, part in row 2, column 2]

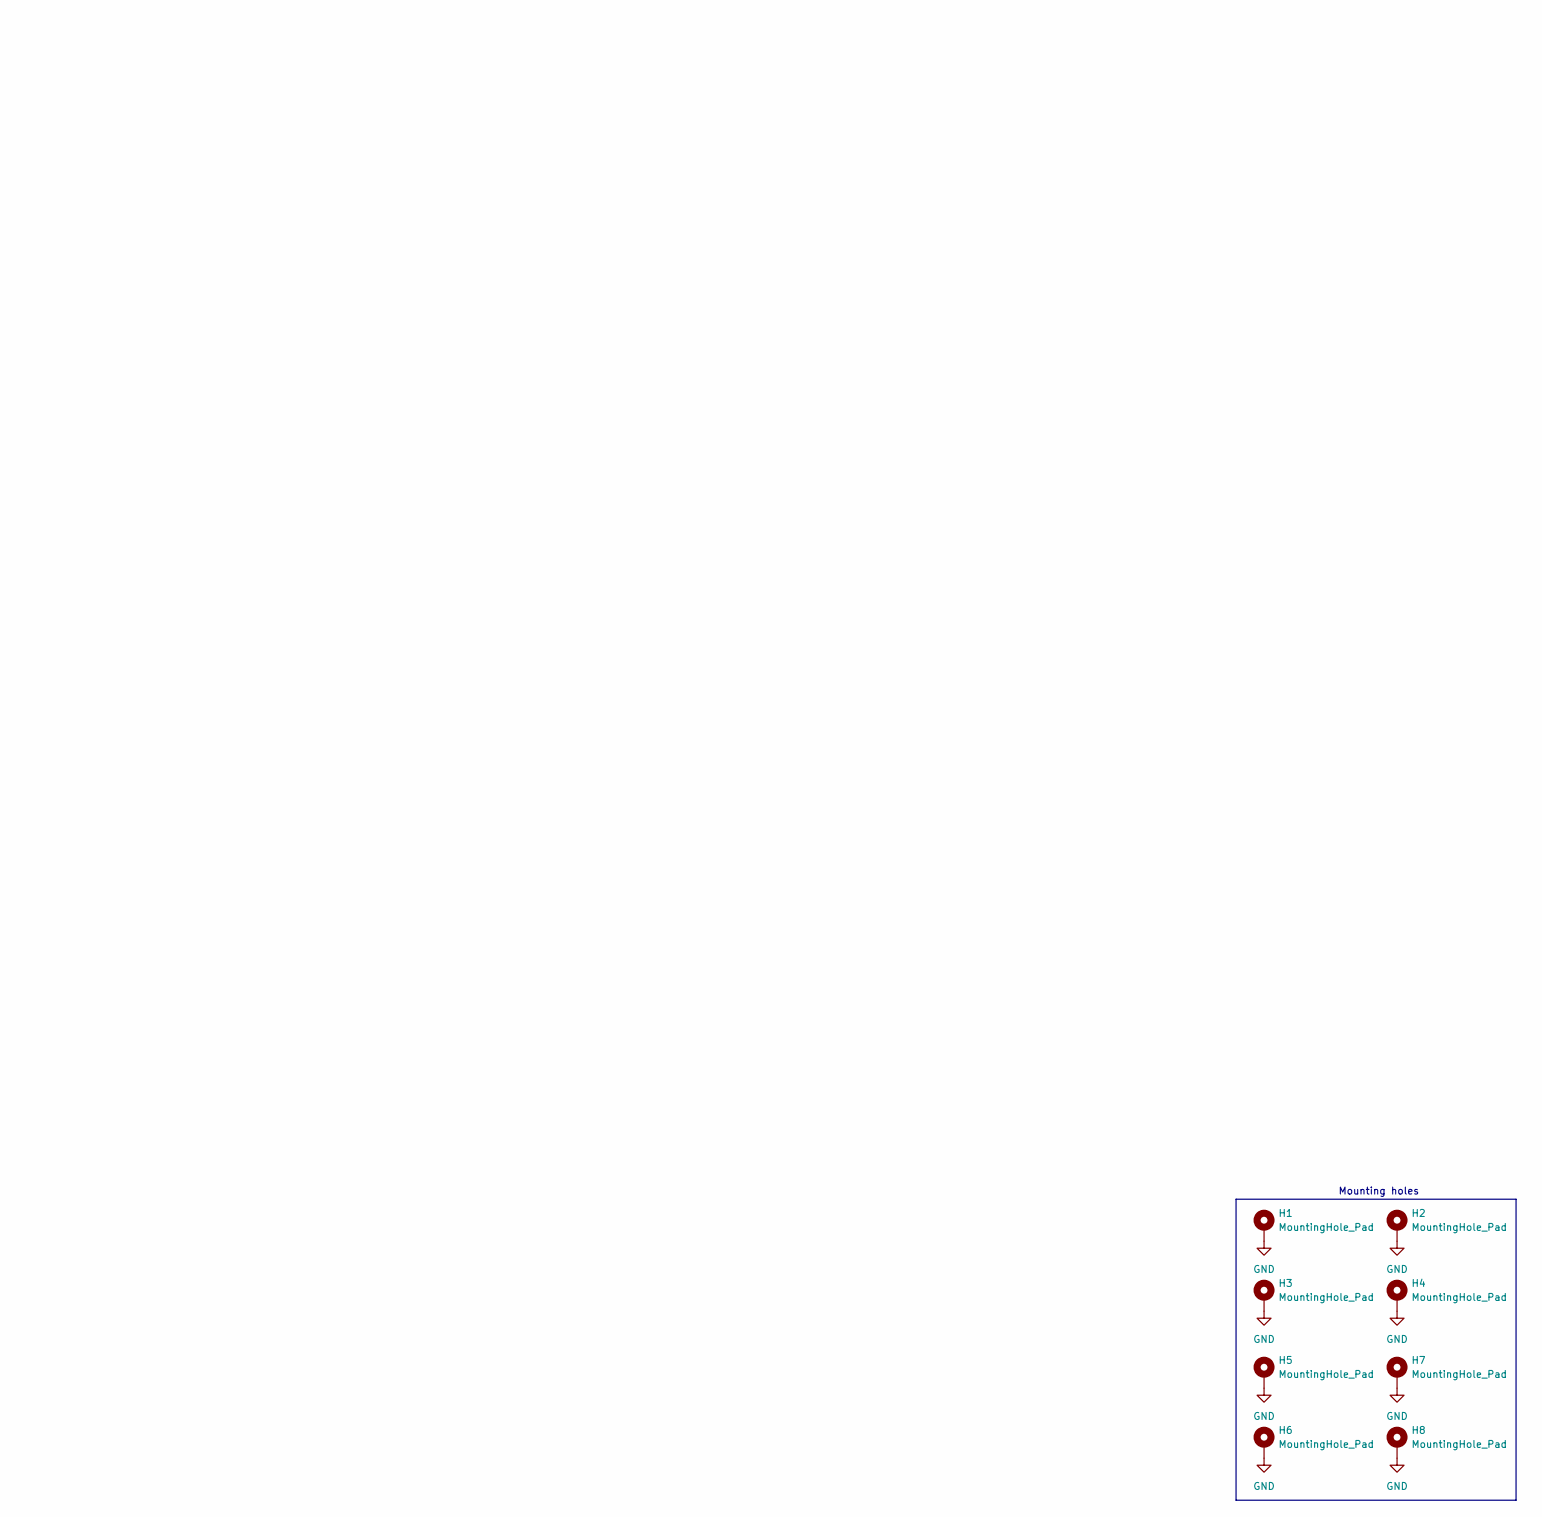
[picture p27: schematic whistler-mic-array.kicad_sch, part in row 2, column 3]

Parts:
C1: 100nF; C_0402_1005Metric; LCSC C1525
C2, C3, C4: 1uF; C_0402_1005Metric; LCSC C14445
C5: 10uF; C_0603_1608Metric; LCSC C18800
C6, C7, C8, C9: 4.7uF; C_0603_1608Metric; LCSC C1705
D2: LED; LED_0603_1608Metric; LCSC C12624
FB11: 680R; C_0402_1005Metric; LCSC C96691
H1, H2, H3, H4, H5, H6, H7, H8: MountingHole_Pad; MountingHole_3.2mm_M3_Pad
J19: Conn_01x24; Hirose_FH12-24S-0.5SH_1x24-1MP_P0.50mm_Horizontal; LCSC C202112
R1, R2, R3, R4: 22R; R_0402_1005Metric; LCSC C25092
R5: 470R; R_0402_1005Metric; LCSC C25117
U3: TPS7A2018PDBVR; SOT-23-5; LCSC C963430
U6: 74LVC125; SOIC-14_3.9x8.7mm_P1.27mm; LCSC C6057

Connections:
+1V8: C4.1, C5.1, C6.1, C7.1, C8.1, C9.1, FB11.1, U3.5 (OUT); also elsewhere on the board
+5V: C3.1, J19.1, J19.2, R5.1, U3.1 (IN), U3.3 (EN)
/PDM_CLK_Q1: R1.2; also elsewhere on the board
/PDM_CLK_Q2: R2.2; also elsewhere on the board
/PDM_CLK_Q3: R3.2; also elsewhere on the board
/PDM_CLK_Q4: R4.2; also elsewhere on the board
/PDM_CLK_XMOS: J19.4, U6.2, U6.5, U6.9, U6.12
/PDM_DATA_0: J19.6; also elsewhere on the board
/PDM_DATA_1: J19.8; also elsewhere on the board
/PDM_DATA_2: J19.10; also elsewhere on the board
/PDM_DATA_3: J19.12; also elsewhere on the board
/PDM_DATA_4: J19.14; also elsewhere on the board
/PDM_DATA_5: J19.16; also elsewhere on the board
/PDM_DATA_6: J19.18; also elsewhere on the board
/PDM_DATA_7: J19.20; also elsewhere on the board
GND: C1.2, C2.2, C3.2, C4.2, C5.2, C6.2, C7.2, C8.2, C9.2, D2.1 (K), H1.1 (1_1), H2.1, H3.1 (1_1), H4.1 (1_1), H5.1, H6.1 (1_1), H7.1 (1_1), H8.1 (1_1), J19.3, J19.5, J19.7, J19.9, J19.11, J19.13, J19.15, J19.17, J19.19, J19.21, J19.22, J19.23, J19.24, J19.MP, U3.2 (GND), U6.1, U6.4, U6.7 (GND), U6.10, U6.13; also elsewhere on the board
unnamed: D2.2 (A), R5.2
unnamed: R1.1, U6.11
unnamed: R2.1, U6.8
unnamed: R3.1, U6.6
unnamed: R4.1, U6.3
unnamed: C1.1, C2.1, FB11.2, U6.14 (VCC)

Notes on the sheet:
Microphone
STEP DOWNS
Mounting holes
Power LED
CLOCK BUFFER

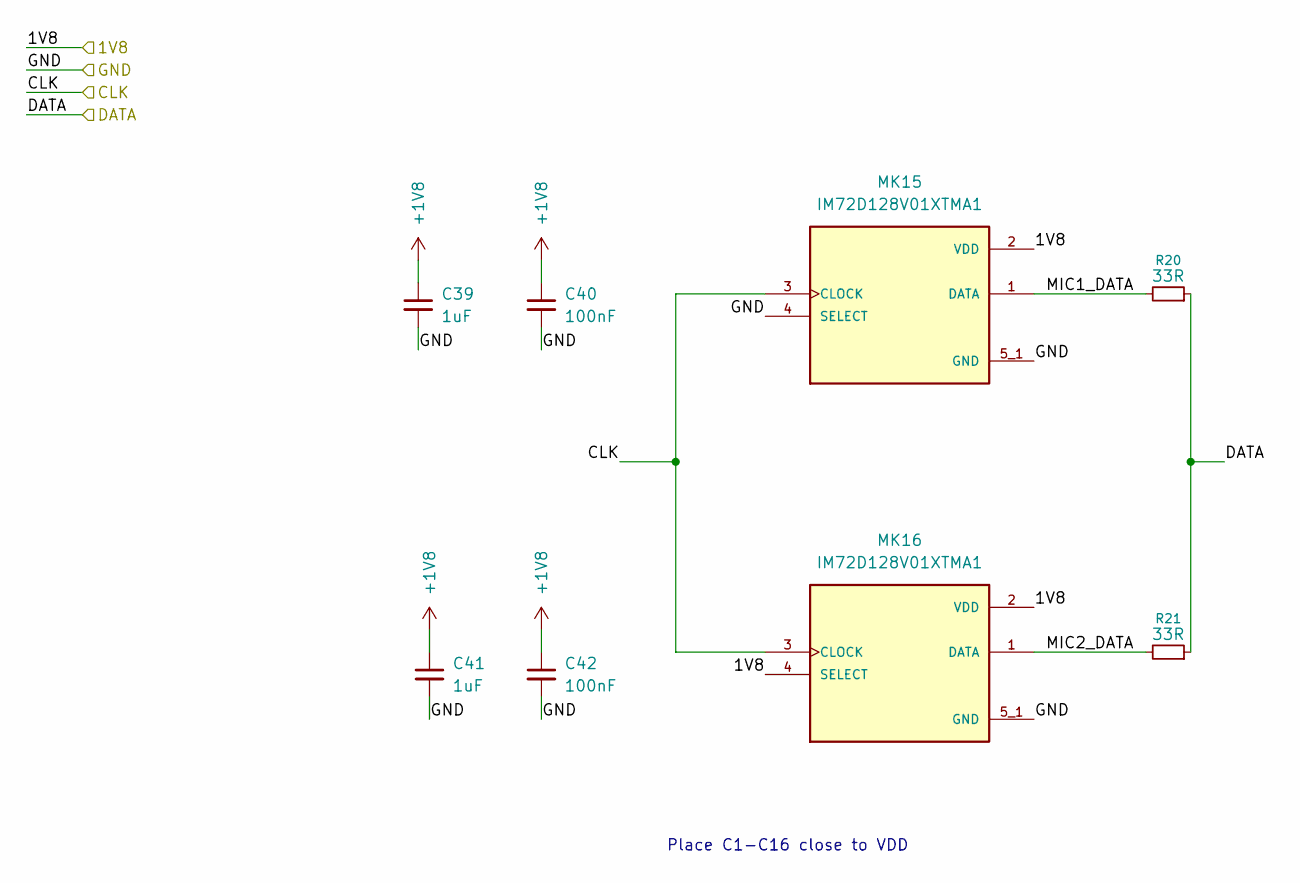
[picture p28: schematic mic-pair.kicad_sch]

Parts:
C39, C41: 1uF; C_0402_1005Metric; LCSC C14445
C40, C42: 100nF; C_0402_1005Metric; LCSC C1525
MK15, MK16: IM72D128V01XTMA1; MIC_IM72D128V01XTMA1; PARTREV 2022-05-05; LCSC C5119248
R20, R21: 33R; R_0402_1005Metric; LCSC C25105

Connections:
+1V8: C39.1, C40.1, C41.1, C42.1, MK15.2 (VDD), MK16.2 (VDD), MK16.4 (SELECT); also elsewhere on the board
/PDM_CLK_Q4: MK15.3 (CLOCK), MK16.3 (CLOCK); also elsewhere on the board
/PDM_DATA_7: R20.1, R21.1; also elsewhere on the board
/Pair8/MIC1_DATA: MK15.1 (DATA), R20.2
/Pair8/MIC2_DATA: MK16.1 (DATA), R21.2
GND: C39.2, C40.2, C41.2, C42.2, MK15.4 (SELECT), MK15.5_1 (GND), MK15.5_2 (GND), MK16.5_1 (GND), MK16.5_2 (GND); also elsewhere on the board

Parts of its further copies:
C11, C13, C15, C17, C19, C21, C23, C25, C27, C29, C31, C33, C35, C37: 1uF; C_0402_1005Metric; LCSC C14445
C12, C14, C16, C18, C20, C22, C24, C26, C28, C30, C32, C34, C36, C38: 100nF; C_0402_1005Metric; LCSC C1525
MK1, MK2, MK3, MK4, MK5, MK6, MK7, MK8, MK9, MK10, MK11, MK12, MK13, MK14: IM72D128V01XTMA1; MIC_IM72D128V01XTMA1; PARTREV 2022-05-05; LCSC C5119248
R6, R7, R8, R9, R10, R11, R12, R13, R14, R15, R16, R17, R18, R19: 33R; R_0402_1005Metric; LCSC C25105

Connections of its further copies:
+1V8: C11.1, C12.1, C13.1, C14.1, C15.1, C16.1, C17.1, C18.1, C19.1, C20.1, C21.1, C22.1, C23.1, C24.1, C25.1, C26.1, C27.1, C28.1, C29.1, C30.1, C31.1, C32.1, C33.1, C34.1, C35.1, C36.1, C37.1, C38.1, MK1.2 (VDD), MK2.2 (VDD), MK2.4 (SELECT), MK3.2 (VDD), MK4.2 (VDD), MK4.4 (SELECT), MK5.2 (VDD), MK6.2 (VDD), MK6.4 (SELECT), MK7.2 (VDD), MK8.2 (VDD), MK8.4 (SELECT), MK9.2 (VDD), MK10.2 (VDD), MK10.4 (SELECT), MK11.2 (VDD), MK12.2 (VDD), MK12.4 (SELECT), MK13.2 (VDD), MK14.2 (VDD), MK14.4 (SELECT); also elsewhere on the board
/PDM_CLK_Q1: MK1.3 (CLOCK), MK2.3 (CLOCK), MK3.3 (CLOCK), MK4.3 (CLOCK); also elsewhere on the board
/PDM_CLK_Q2: MK5.3 (CLOCK), MK6.3 (CLOCK), MK7.3 (CLOCK), MK8.3 (CLOCK); also elsewhere on the board
/PDM_CLK_Q3: MK9.3 (CLOCK), MK10.3 (CLOCK), MK11.3 (CLOCK), MK12.3 (CLOCK); also elsewhere on the board
/PDM_CLK_Q4: MK13.3 (CLOCK), MK14.3 (CLOCK); also elsewhere on the board
/PDM_DATA_0: R6.1, R7.1; also elsewhere on the board
/PDM_DATA_1: R8.1, R9.1; also elsewhere on the board
/PDM_DATA_2: R10.1, R11.1; also elsewhere on the board
/PDM_DATA_3: R12.1, R13.1; also elsewhere on the board
/PDM_DATA_4: R14.1, R15.1; also elsewhere on the board
/PDM_DATA_5: R16.1, R17.1; also elsewhere on the board
/PDM_DATA_6: R18.1, R19.1; also elsewhere on the board
/Pair1/MIC1_DATA: MK1.1 (DATA), R6.2
/Pair1/MIC2_DATA: MK2.1 (DATA), R7.2
/Pair2/MIC1_DATA: MK3.1 (DATA), R8.2
/Pair2/MIC2_DATA: MK4.1 (DATA), R9.2
/Pair3/MIC1_DATA: MK5.1 (DATA), R10.2
/Pair3/MIC2_DATA: MK6.1 (DATA), R11.2
/Pair4/MIC1_DATA: MK7.1 (DATA), R12.2
/Pair4/MIC2_DATA: MK8.1 (DATA), R13.2
/Pair5/MIC1_DATA: MK9.1 (DATA), R14.2
/Pair5/MIC2_DATA: MK10.1 (DATA), R15.2
/Pair6/MIC1_DATA: MK11.1 (DATA), R16.2
/Pair6/MIC2_DATA: MK12.1 (DATA), R17.2
/Pair7/MIC1_DATA: MK13.1 (DATA), R18.2
/Pair7/MIC2_DATA: MK14.1 (DATA), R19.2
GND: C11.2, C12.2, C13.2, C14.2, C15.2, C16.2, C17.2, C18.2, C19.2, C20.2, C21.2, C22.2, C23.2, C24.2, C25.2, C26.2, C27.2, C28.2, C29.2, C30.2, C31.2, C32.2, C33.2, C34.2, C35.2, C36.2, C37.2, C38.2, MK1.4 (SELECT), MK1.5_1 (GND), MK1.5_2 (GND), MK2.5_1 (GND), MK2.5_2 (GND), MK3.4 (SELECT), MK3.5_1 (GND), MK3.5_2 (GND), MK4.5_1 (GND), MK4.5_2 (GND), MK5.4 (SELECT), MK5.5_1 (GND), MK5.5_2 (GND), MK6.5_1 (GND), MK6.5_2 (GND), MK7.4 (SELECT), MK7.5_1 (GND), MK7.5_2 (GND), MK8.5_1 (GND), MK8.5_2 (GND), MK9.4 (SELECT), MK9.5_1 (GND), MK9.5_2 (GND), MK10.5_1 (GND), MK10.5_2 (GND), MK11.4 (SELECT), MK11.5_1 (GND), MK11.5_2 (GND), MK12.5_1 (GND), MK12.5_2 (GND), MK13.4 (SELECT), MK13.5_1 (GND), MK13.5_2 (GND), MK14.5_1 (GND), MK14.5_2 (GND); also elsewhere on the board

Notes on the sheet:
Place C1-C16 close to VDD

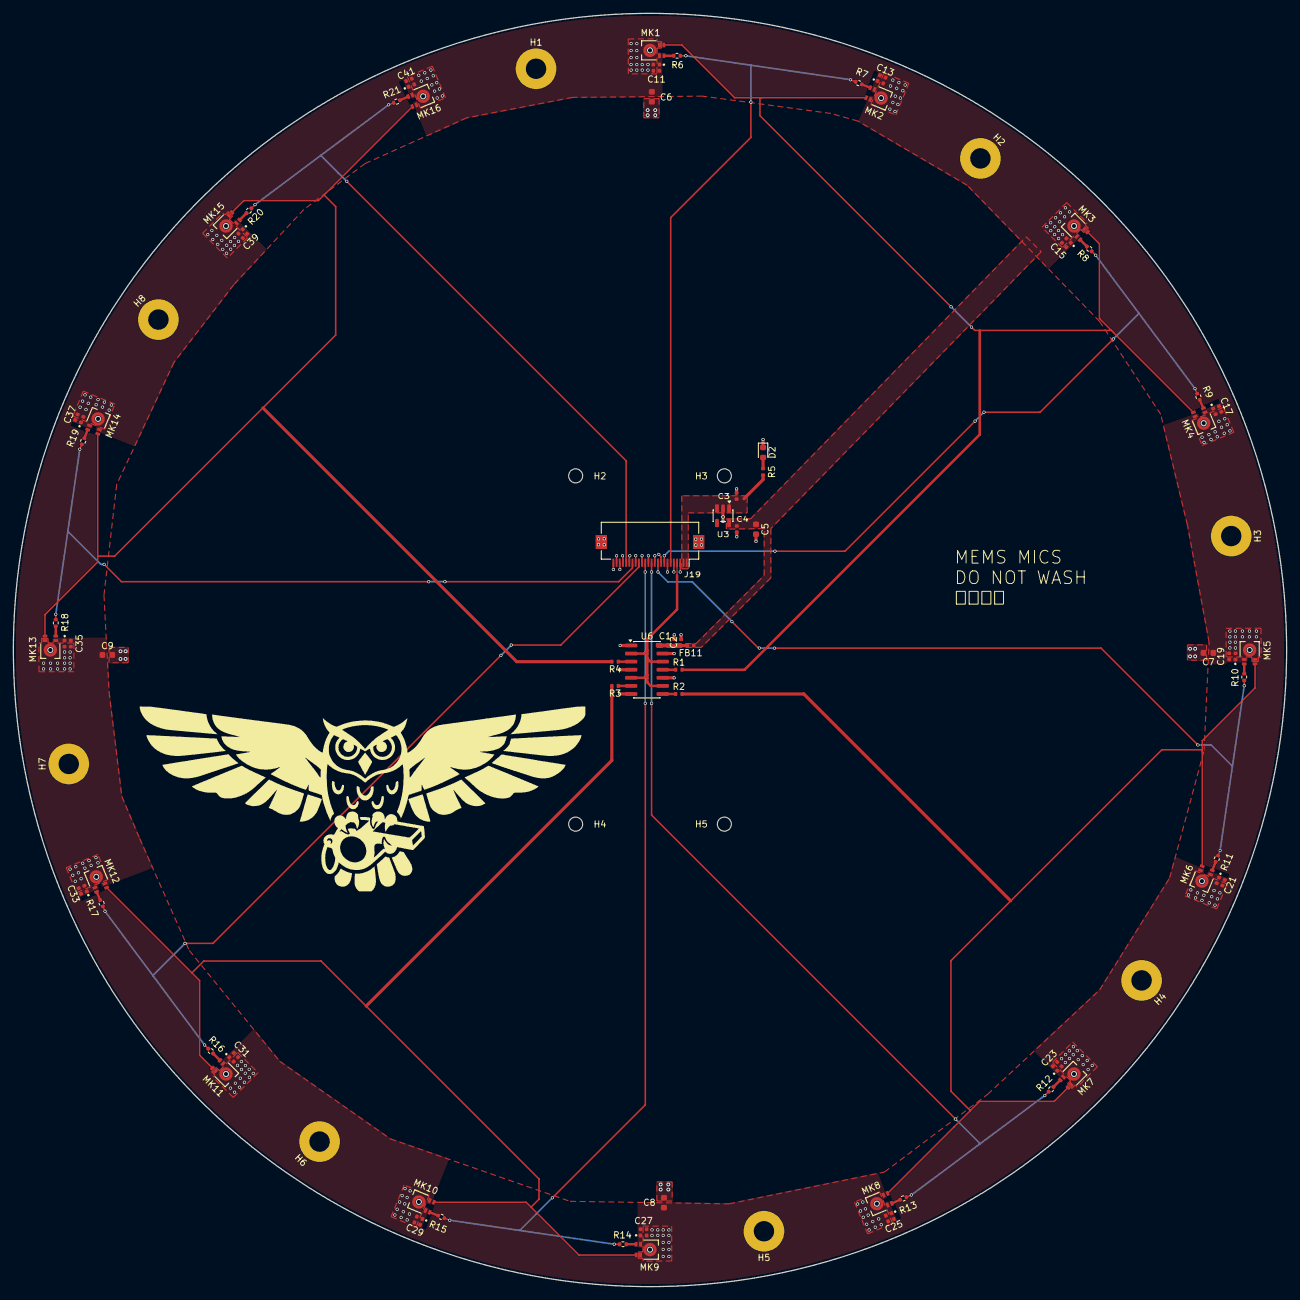
[picture p29: board whistler-mic-array.kicad_pcb from above]

Board: 2 copper layers, 200.0 x 200.0 mm, 95 parts (0 on the bottom side), 38 nets.

Other parts of the board:
H2#2, H5#2: MountingHole_Pad; MountingHole_3.2mm_M3_Pad
H3#2, H4#2: MountingHole; MountingHole_2.2mm_M2

Their connections:
GND: H2#2.1 (1_1), H5#2.1 (1_1); also elsewhere on the board
