ccc909/Whistler/motherboard/whistler-motherboard.kicad_pcb

## KiCad design motherboard/whistler-motherboard.kicad_pcb (2026-10-23)

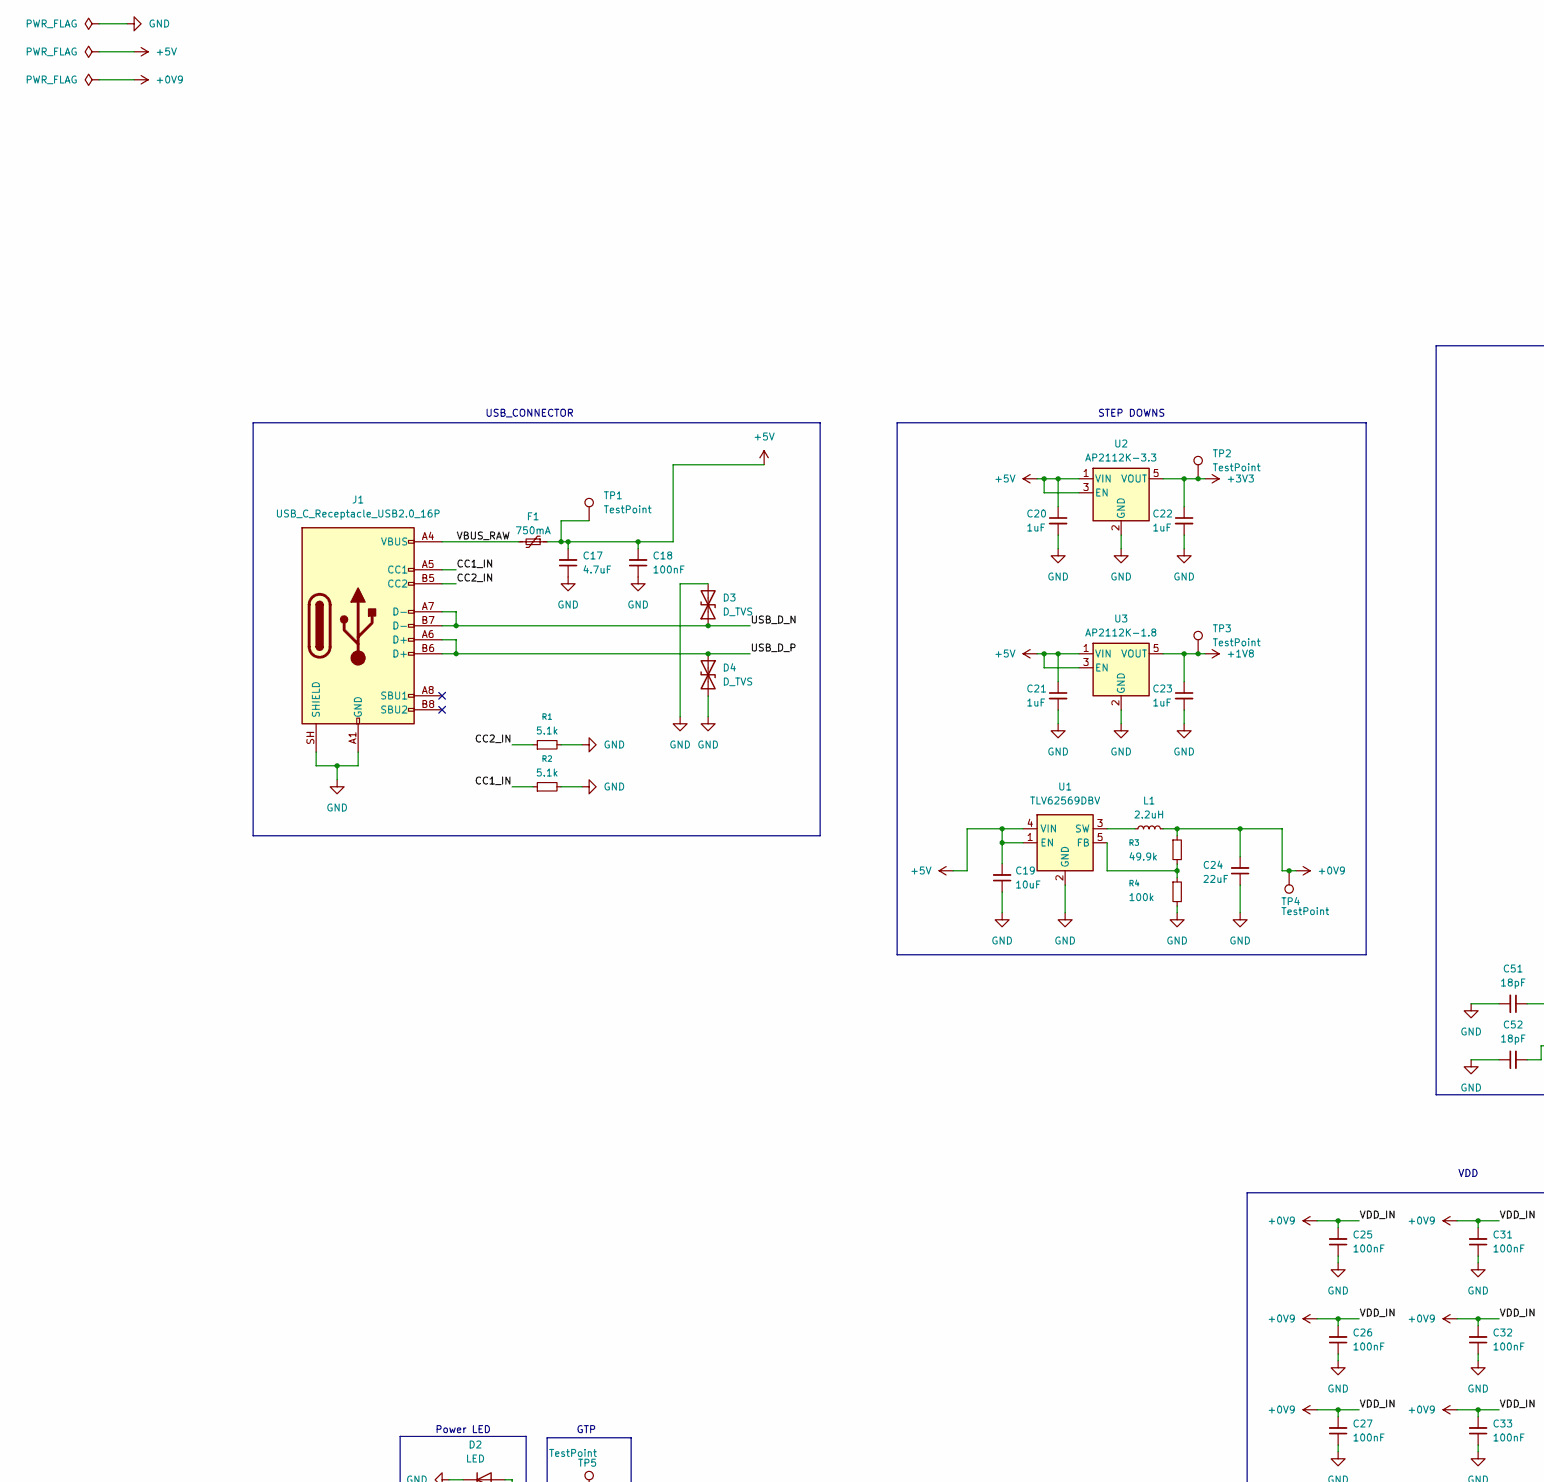
[picture p30: schematic whistler-motherboard.kicad_sch, part in row 1, column 1]

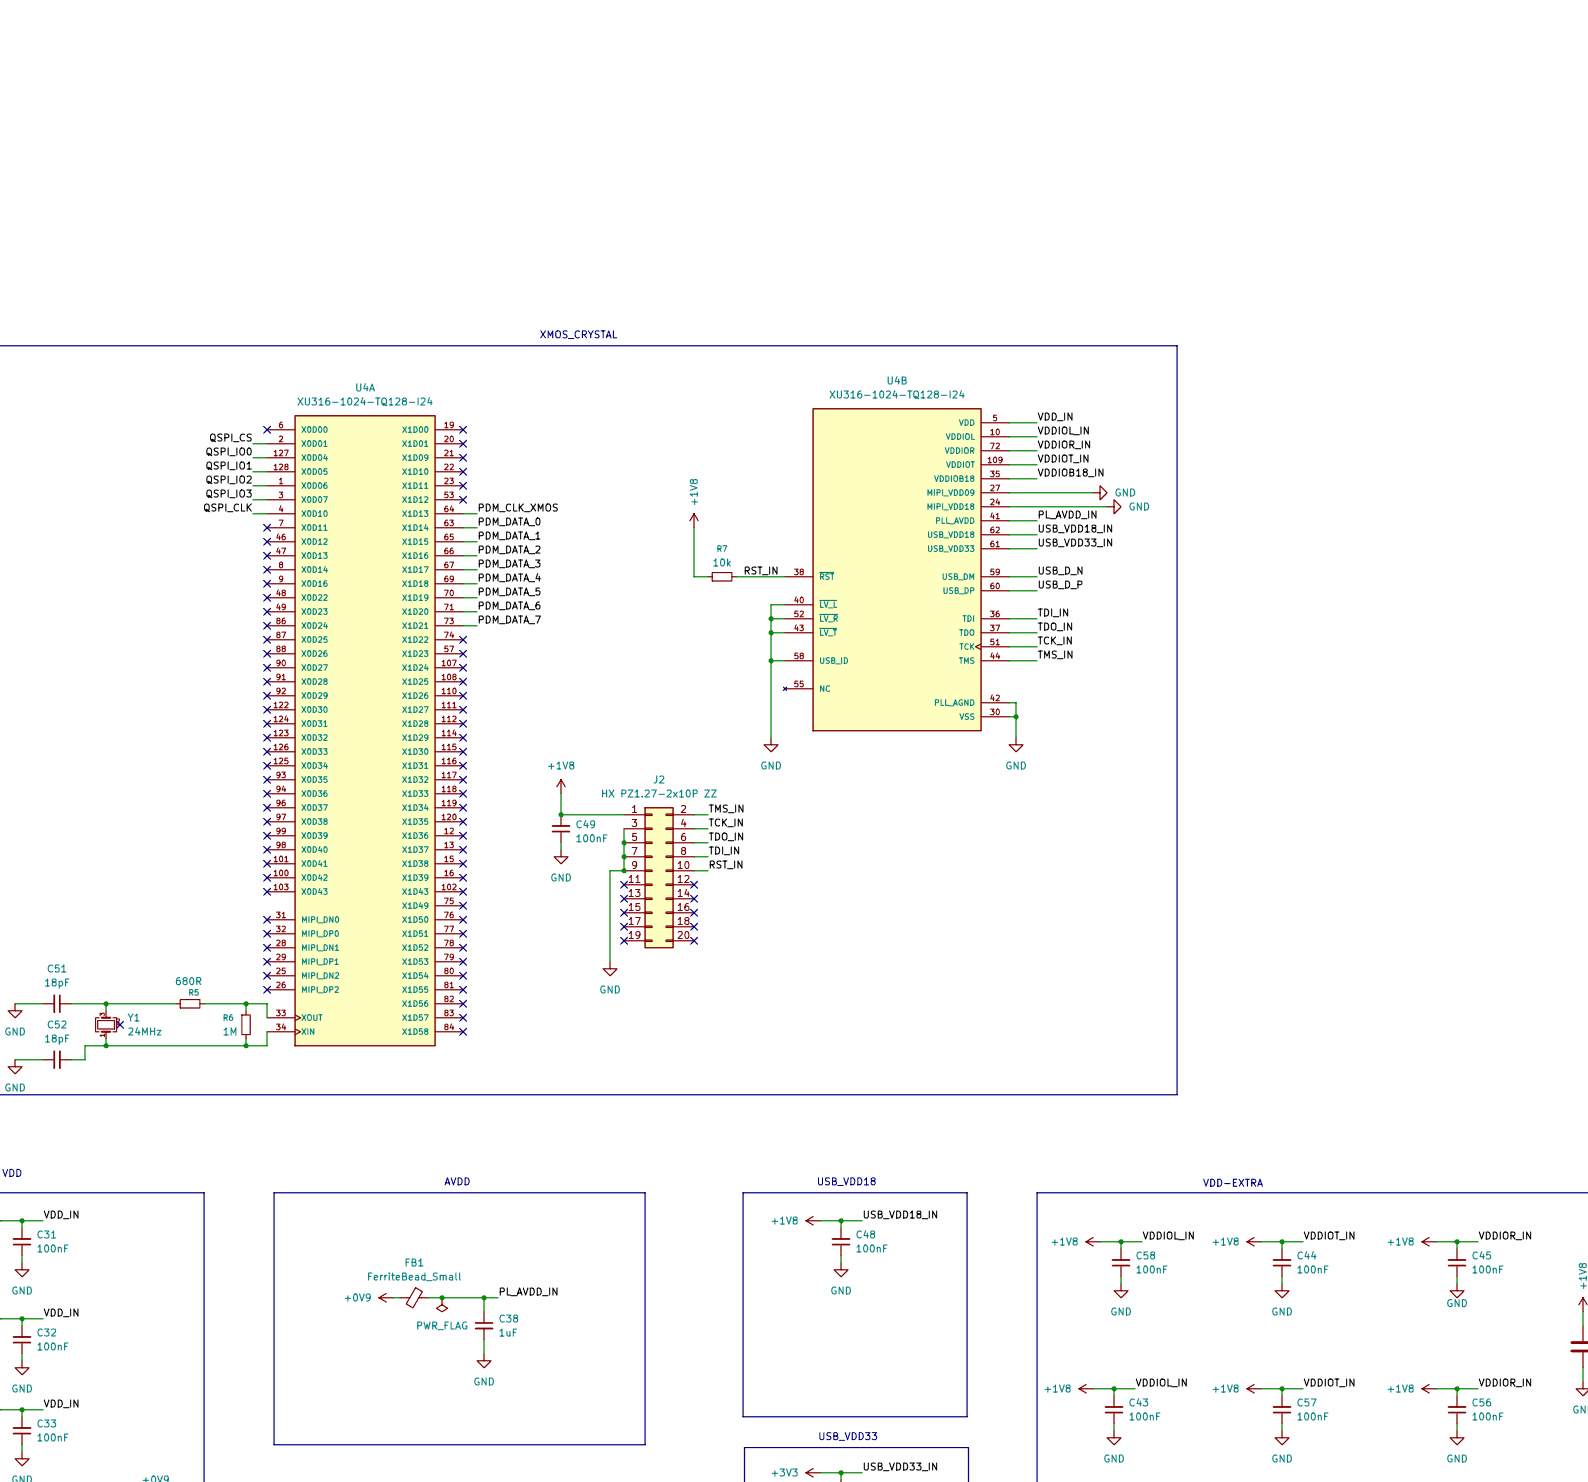
[picture p31: schematic whistler-motherboard.kicad_sch, part in row 1, column 2]

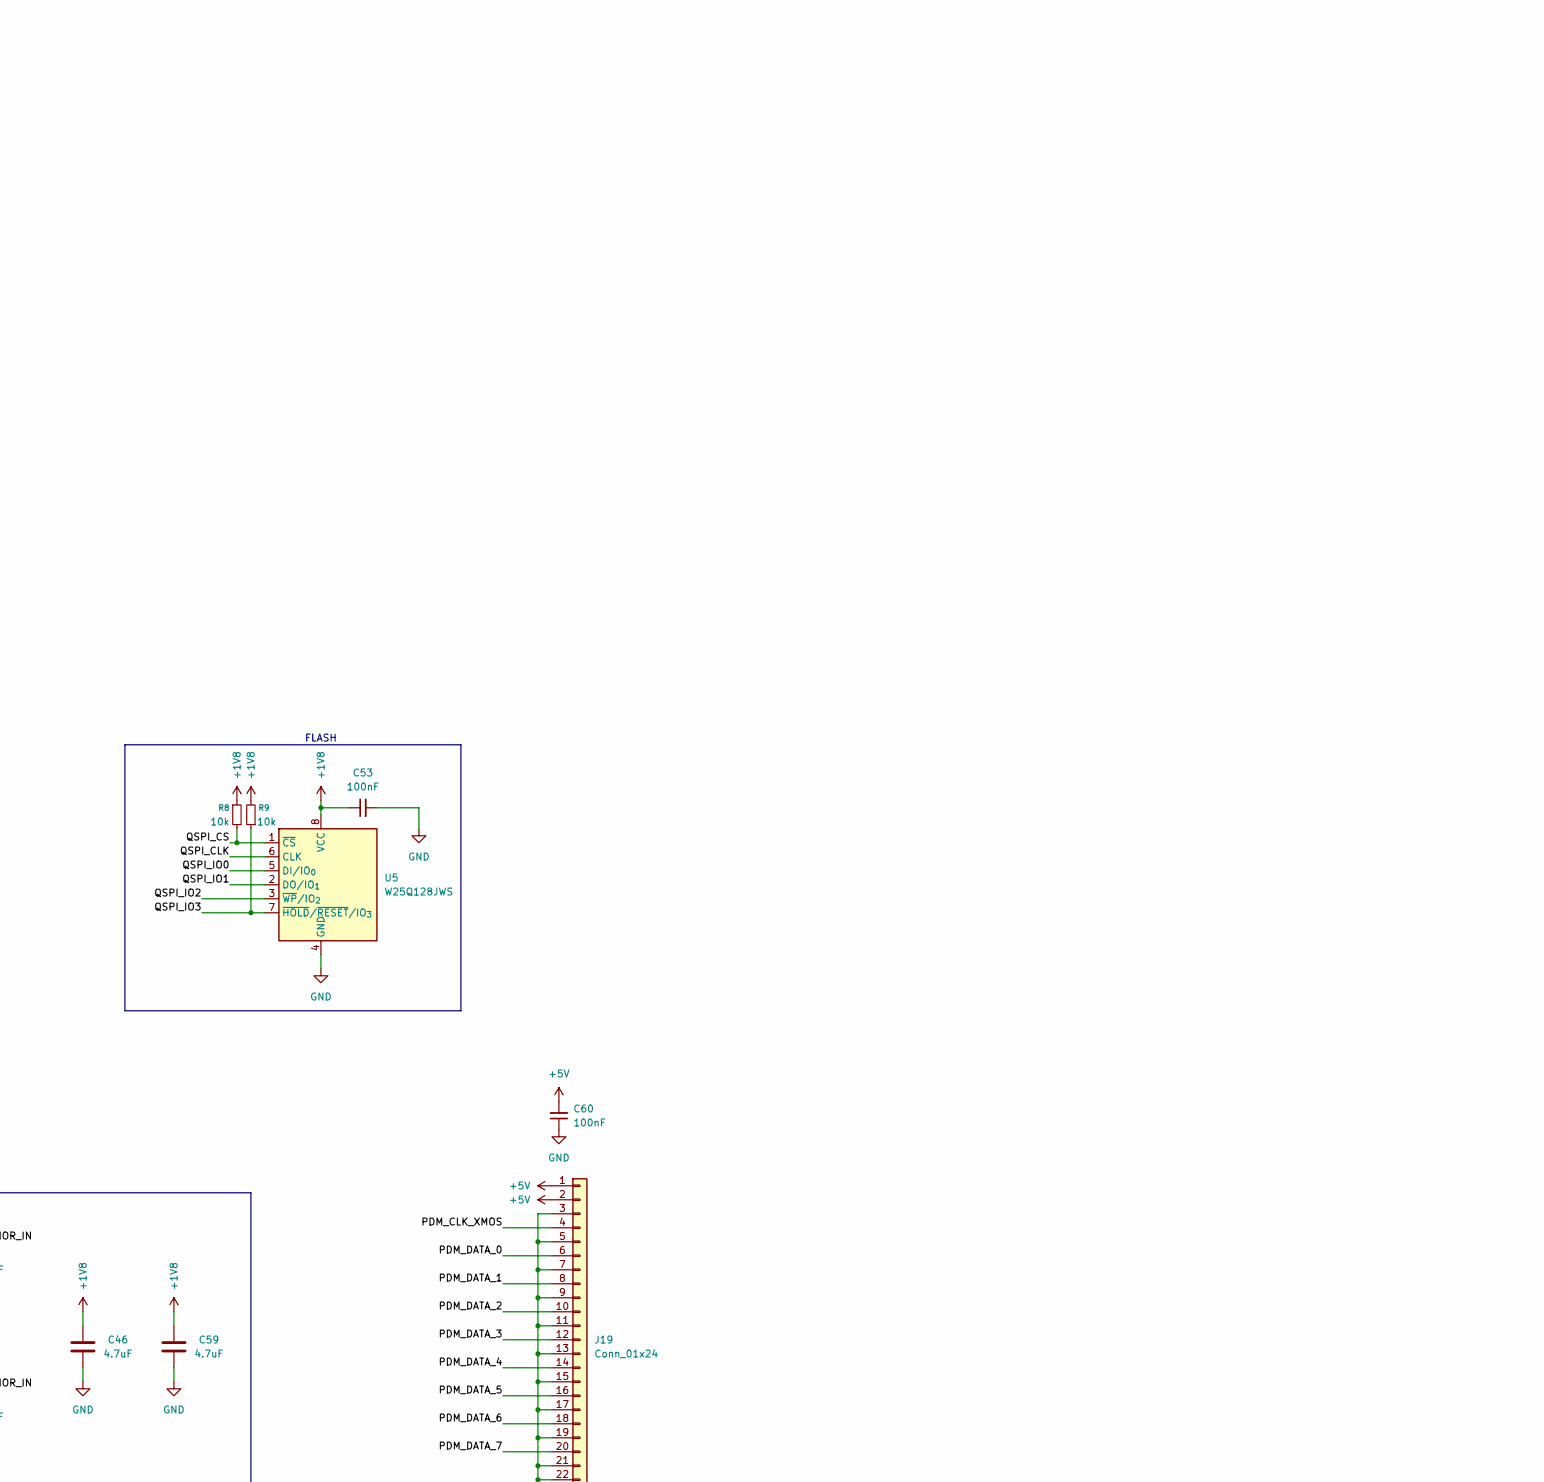
[picture p32: schematic whistler-motherboard.kicad_sch, part in row 1, column 3]

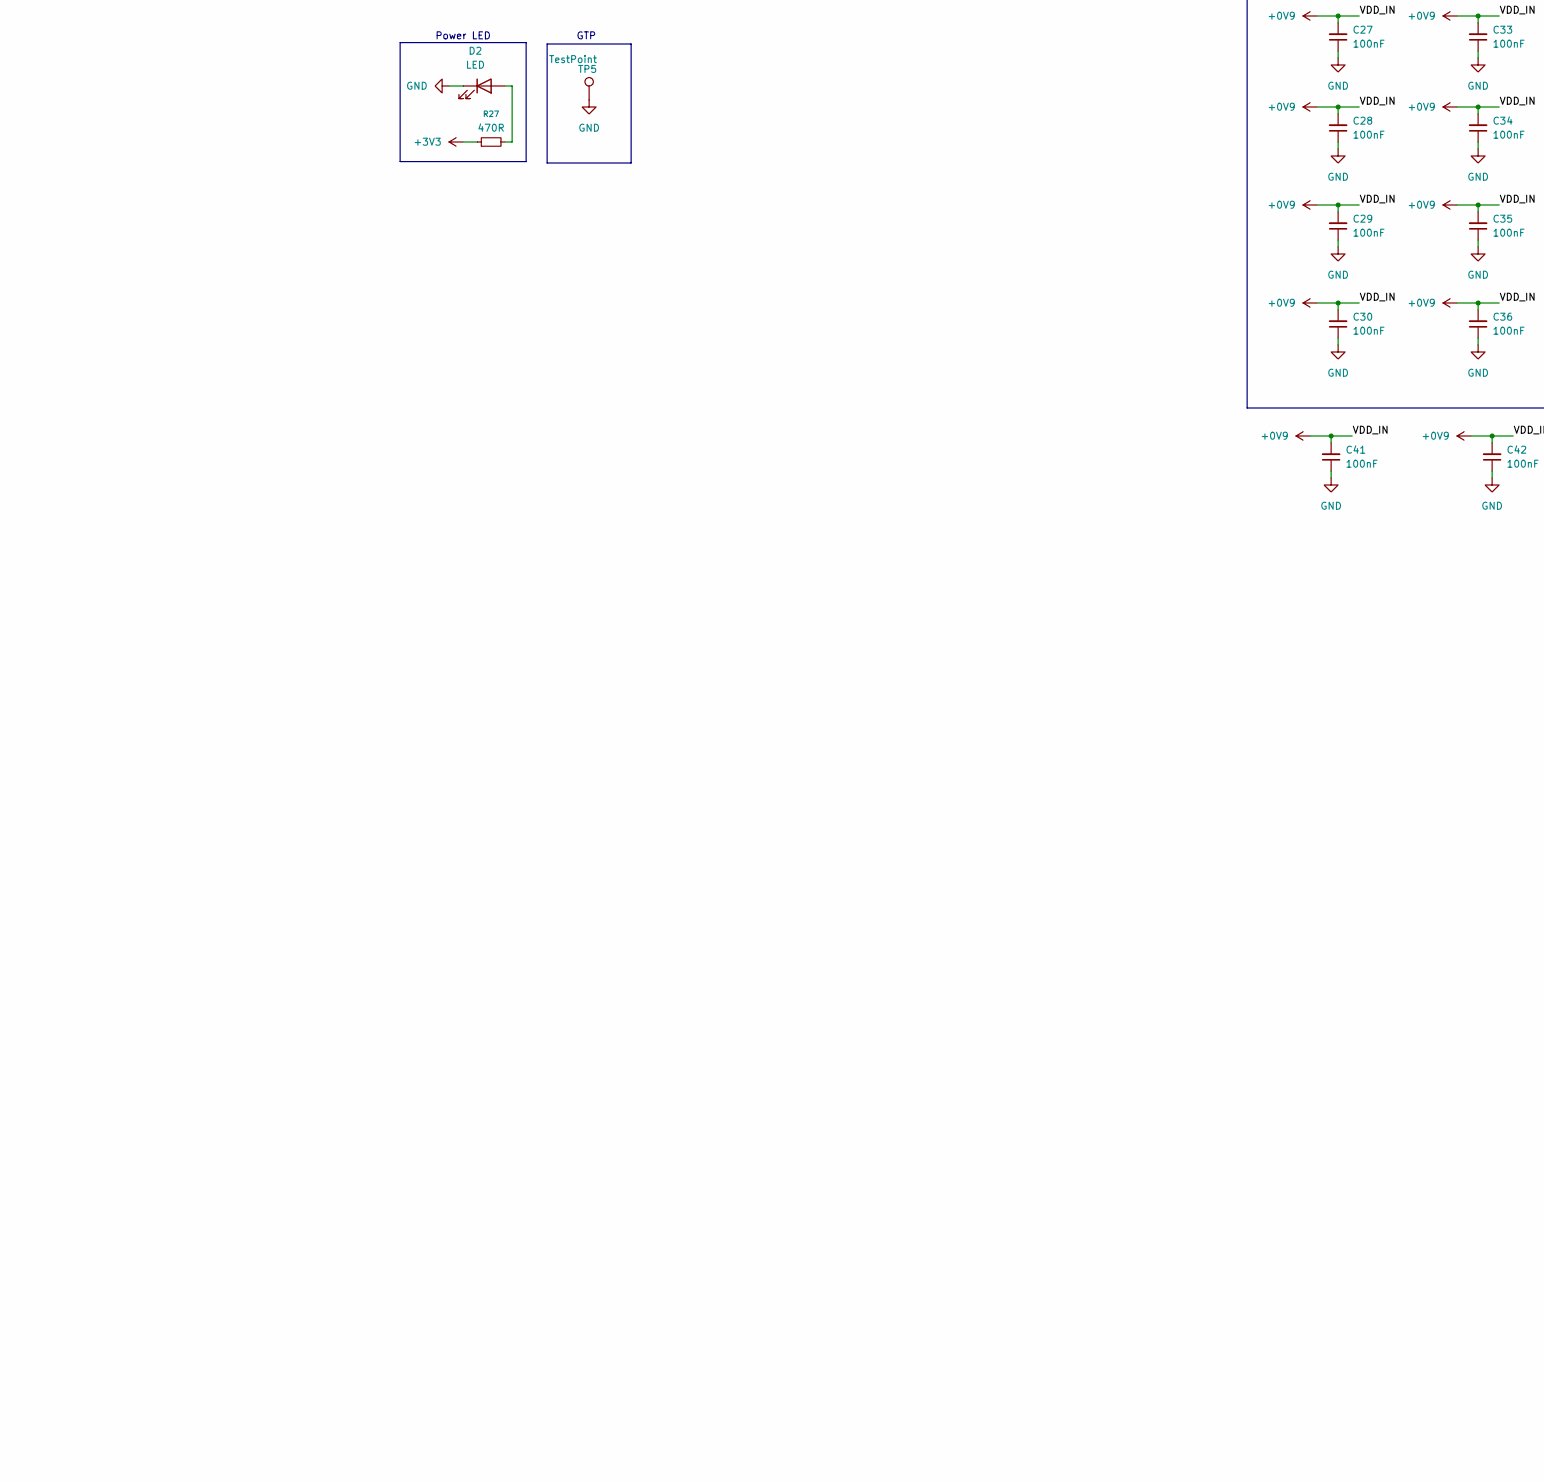
[picture p33: schematic whistler-motherboard.kicad_sch, part in row 2, column 1]

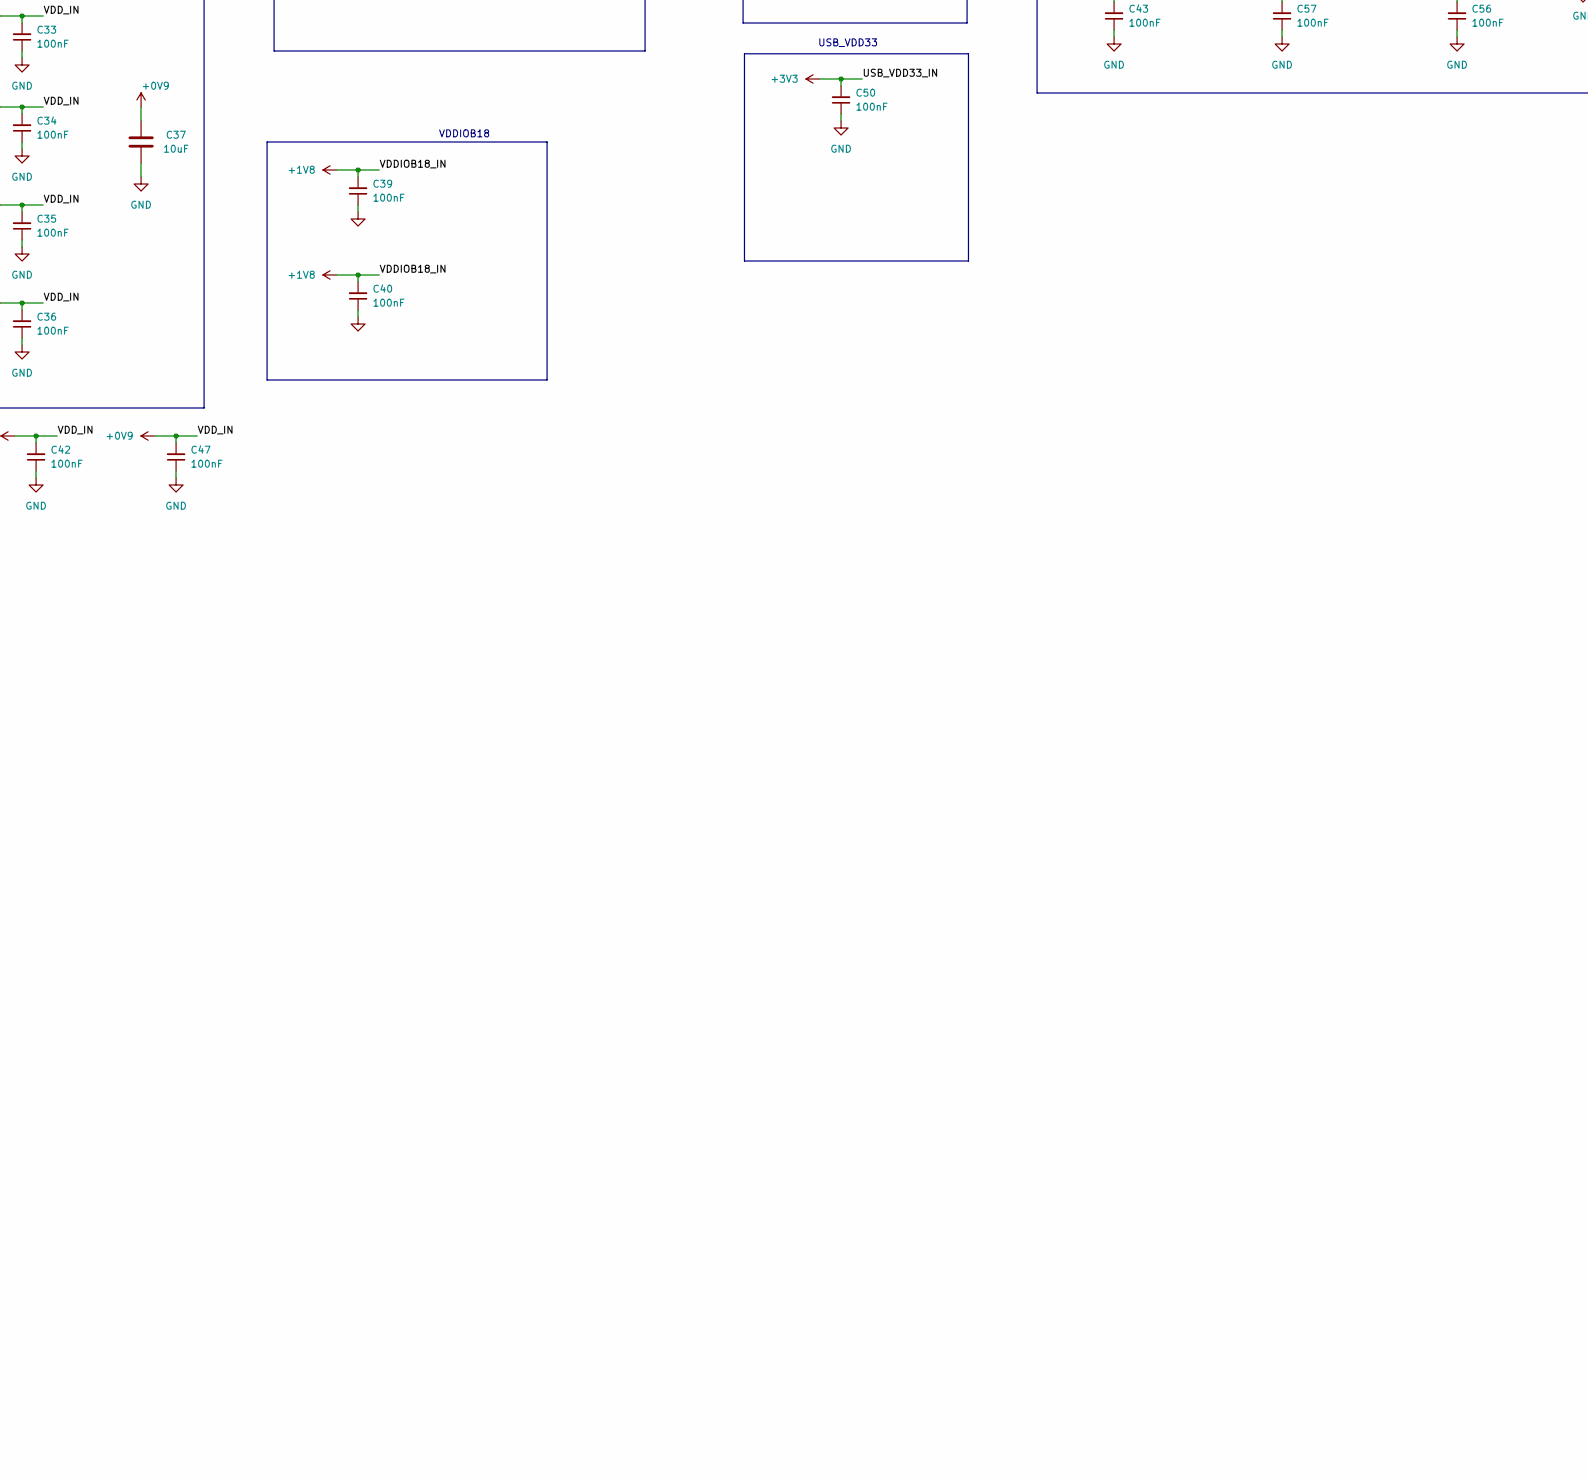
[picture p34: schematic whistler-motherboard.kicad_sch, part in row 2, column 2]

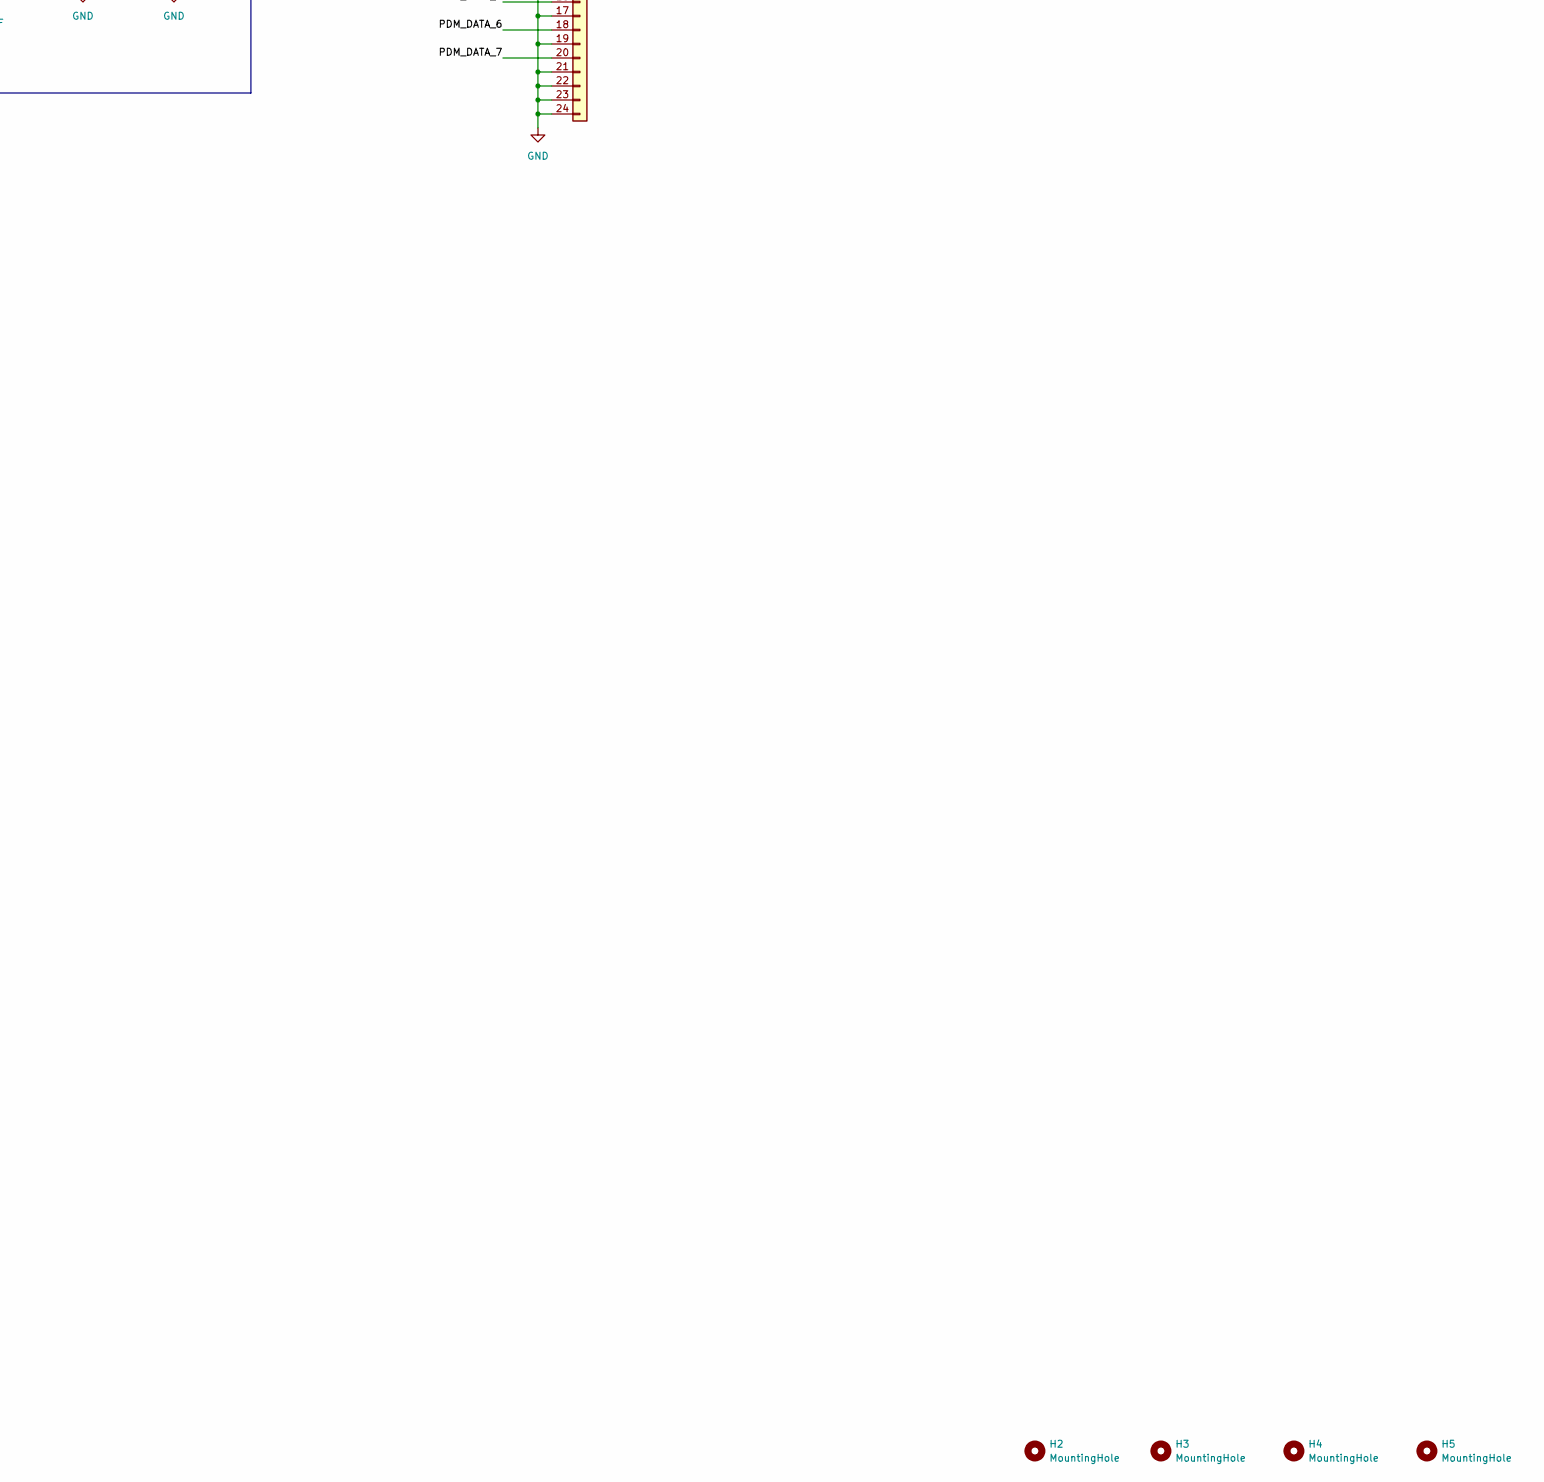
[picture p35: schematic whistler-motherboard.kicad_sch, part in row 2, column 3]

Parts:
C17, C46, C59: 4.7uF; C_0603_1608Metric; LCSC C1705
C18, C25, C26, C27, C28, C29, C30, C31, C32, C33, C34, C35, C36, C39, C40, C41, C42, C43, C44, C45, C47, C48, C49, C50, C53, C56, C57, C58, C60: 100nF; C_0402_1005Metric; LCSC C1525
C19, C37: 10uF; C_0603_1608Metric; LCSC C96446
C20, C21, C22, C23, C38: 1uF; C_0402_1005Metric; LCSC C52923
C24: 22uF; C_0603_1608Metric; LCSC C109448
C51, C52: 18pF; C_0402_1005Metric; LCSC C1549
D2: LED; LED_0603_1608Metric; LCSC C2289
D3, D4: D_TVS; D_0402_1005Metric; LCSC C558615
F1: 750mA; Fuse_1206_3216Metric; LCSC C371166
FB1: FerriteBead_Small; L_0603_1608Metric; LCSC C85833
H2, H3, H4, H5: MountingHole; MountingHole_2.2mm_M2
J1: USB_C_Receptacle_USB2.0_16P; USB_C_Receptacle_GCT_USB4105-xx-A_16P_TopMnt_Horizontal; LCSC C3025063
J2: HX PZ1.27-2x10P ZZ; PinHeader_2x10_P1.27mm_Vertical; LCSC C22438125
J19: Conn_01x24; Hirose_FH12-24S-0.5SH_1x24-1MP_P0.50mm_Horizontal; LCSC C202112
L1: 2.2uH; INDC2016X120N; LCSC C337893
R1, R2: 5.1k; R_0402_1005Metric; LCSC C25905
R3: 49.9k; R_0402_1005Metric; LCSC C137969
R4: 100k; R_0402_1005Metric; LCSC C25741
R5: 680R; R_0402_1005Metric; LCSC C25130
R6: 1M; R_0402_1005Metric; LCSC C26083
R7, R8, R9: 10k; R_0402_1005Metric; LCSC C25744
R27: 470R; R_0402_1005Metric; LCSC C25117
TP1, TP2, TP3, TP4, TP5: TestPoint; TestPoint_Pad_1.0x1.0mm
U1: TLV62569DBV; SOT-23-5; LCSC C141836
U2: AP2112K-3.3; SOT-23-5; LCSC C23380830
U3: AP2112K-1.8; SOT-23-5; LCSC C3021123
U4: XU316-1024-TQ128-I24; QFP40P1600X1600X120-129N; PARTREV 2025/1/13; LCSC C6938291
U5: W25Q128JWS; SOIC-8_5.3x5.3mm_P1.27mm; LCSC C2763561
Y1: 24MHz; Crystal_SMD_3225-4Pin_3.2x2.5mm; LCSC C70590

Connections:
+0V9: C24.2, C25.2, C26.2, C27.2, C28.2, C29.2, C30.2, C31.2, C32.2, C33.2, C34.2, C35.2, C36.2, C37.1, C41.2, C42.2, C47.2, FB1.2, L1.2, R3.1, TP4.1 (1_1), U4.5 (VDD), U4.11 (VDD), U4.14 (VDD), U4.18 (VDD), U4.39 (VDD), U4.45 (VDD), U4.50 (VDD), U4.54 (VDD), U4.68 (VDD), U4.85 (VDD), U4.95 (VDD), U4.104 (VDD), U4.105 (VDD), U4.106 (VDD), U4.113 (VDD)
+1V8: C23.1, C39.2, C40.2, C43.2, C44.2, C45.2, C46.1, C48.2, C49.2, C53.1, C56.2, C57.2, C58.2, C59.1, J2.1, R7.1, R8.1, R9.2, TP3.1 (1_1), U3.5 (VOUT), U4.10 (VDDIOL), U4.17 (VDDIOL), U4.35 (VDDIOB18), U4.56 (VDDIOB18), U4.62 (USB_VDD18), U4.72 (VDDIOR), U4.89 (VDDIOR), U4.109 (VDDIOT), U4.121 (VDDIOT), U5.8 (VCC)
+3V3: C22.1, C50.2, R27.1, TP2.1 (1_1), U2.5 (VOUT), U4.61 (USB_VDD33)
+5V: C17.2, C18.2, C19.2, C20.1, C21.1, C60.2, F1.1, J19.1, J19.2, TP1.1 (1_1), U1.1 (EN), U1.4 (VIN), U2.1 (VIN), U2.3 (EN), U3.1 (VIN), U3.3 (EN)
/CC1_IN: J1.A5 (CC1), R2.1
/CC2_IN: J1.B5 (CC2), R1.1
/PDM_CLK_XMOS: J19.4, U4.64 (X1D13)
/PDM_DATA_0: J19.6, U4.63 (X1D14)
/PDM_DATA_1: J19.8, U4.65 (X1D15)
/PDM_DATA_2: J19.10, U4.66 (X1D16)
/PDM_DATA_3: J19.12, U4.67 (X1D17)
/PDM_DATA_4: J19.14, U4.69 (X1D18)
/PDM_DATA_5: J19.16, U4.70 (X1D19)
/PDM_DATA_6: J19.18, U4.71 (X1D20)
/PDM_DATA_7: J19.20, U4.73 (X1D21)
/PL_AVDD_IN: C38.1, FB1.1, U4.41 (PLL_AVDD)
/QSPI_CLK: U4.4 (X0D10), U5.6 (CLK)
/QSPI_CS: R8.2, U4.2 (X0D01), U5.1 (~CS)
/QSPI_IO0: U4.127 (X0D04), U5.5 (DI/IO_{0})
/QSPI_IO1: U4.128 (X0D05), U5.2 (DO/IO_{1})
/QSPI_IO2: U4.1 (X0D06), U5.3 (~WP/IO_{2})
/QSPI_IO3: R9.1, U4.3 (X0D07), U5.7 (~HOLD/~RESET/IO_{3})
/RST_IN: J2.10, R7.2, U4.38 (~RST)
/TCK_IN: J2.4, U4.51 (TCK)
/TDI_IN: J2.8, U4.36 (TDI)
/TDO_IN: J2.6, U4.37 (TDO)
/TMS_IN: J2.2, U4.44 (TMS)
/USB_D_N: D3.1 (A1), J1.A7 (D-), J1.B7 (D-), U4.59 (USB_DM)
/USB_D_P: D4.1 (A1), J1.A6 (D+), J1.B6 (D+), U4.60 (USB_DP)
/VBUS_RAW: F1.2, J1.A4 (VBUS), J1.A9 (VBUS), J1.B4 (VBUS), J1.B9 (VBUS)
GND: C17.1, C18.1, C19.1, C20.2, C21.2, C22.2, C23.2, C24.1, C25.1, C26.1, C27.1, C28.1, C29.1, C30.1, C31.1, C32.1, C33.1, C34.1, C35.1, C36.1, C37.2, C38.2, C39.1, C40.1, C41.1, C42.1, C43.1, C44.1, C45.1, C46.2, C47.1, C48.1, C49.1, C50.1, C51.2, C52.1, C53.2, C56.1, C57.1, C58.1, C59.2, C60.1, D2.1 (K), D3.2 (A2), D4.2 (A2), J1.A1 (GND), J1.A12 (GND), J1.B1 (GND), J1.B12 (GND), J1.SH (SHIELD), J2.3, J2.5, J2.7, J2.9, J19.3, J19.5, J19.7, J19.9, J19.11, J19.13, J19.15, J19.17, J19.19, J19.21, J19.22, J19.23, J19.24, R1.2, R2.2, R4.2, TP5.1 (1_1), U1.2 (GND), U2.2 (GND), U3.2 (GND), U4.24 (MIPI_VDD18), U4.27 (MIPI_VDD09), U4.30 (VSS), U4.40 (~LV_L), U4.42 (PLL_AGND), U4.43 (~LV_T), U4.52 (~LV_R), U4.58 (USB_ID), U4.129 (VSS), U5.4 (GND)
unnamed: C51.1, R5.1, Y1.3
unnamed: D2.2 (A), R27.2
unnamed: R3.2, R4.1, U1.5 (FB)
unnamed: L1.1, U1.3 (SW)
unnamed: C52.2, R6.2, U4.34 (XIN), Y1.1
unnamed: R5.2, R6.1, U4.33 (XOUT)

Notes on the sheet:
USB_CONNECTOR
STEP DOWNS
FLASH
VDDIOB18
VDD-EXTRA
USB_VDD33
AVDD
GTP
Power LED
XMOS_CRYSTAL
USB_VDD18
VDD

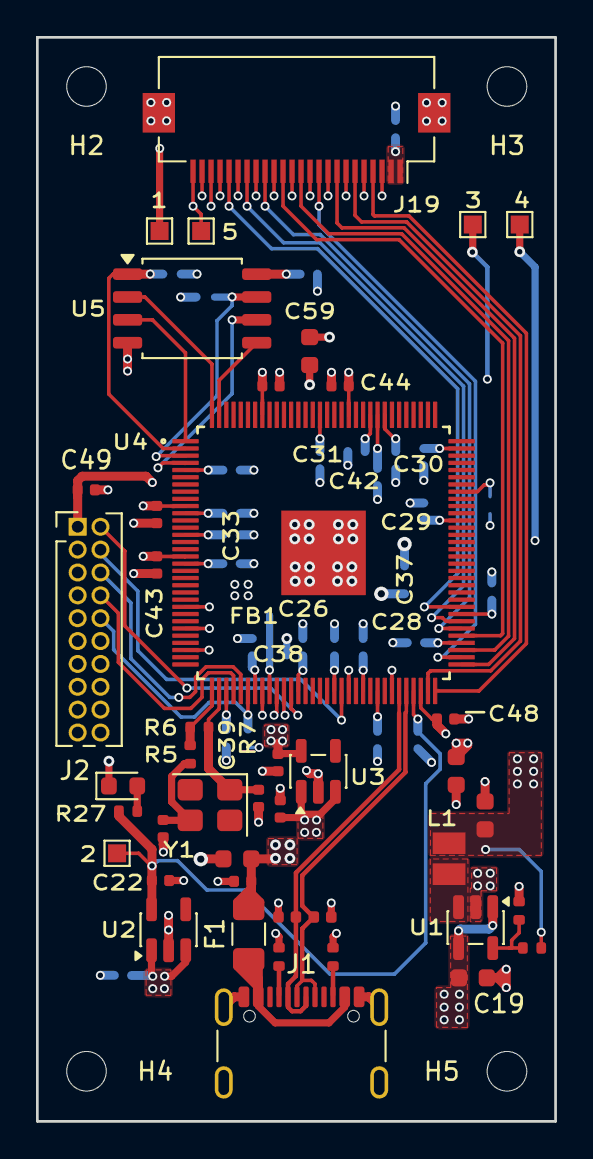
[picture p36: board whistler-motherboard.kicad_pcb from above]

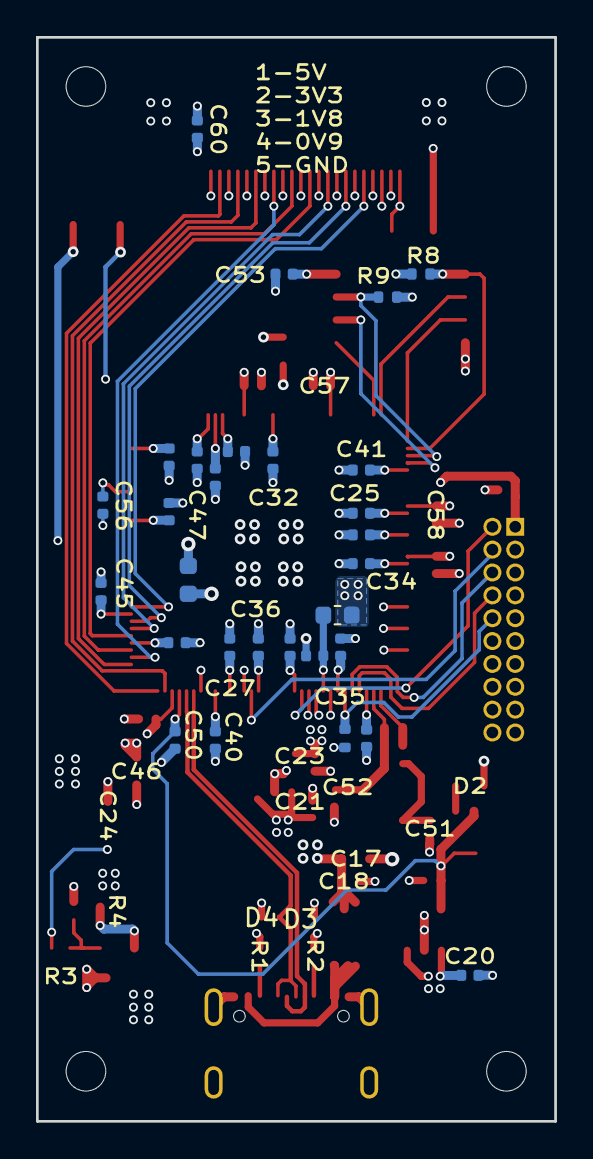
[picture p37: board whistler-motherboard.kicad_pcb from below]

Board: 4 copper layers, 28.8 x 60.2 mm, 76 parts (29 on the bottom side), 37 nets.
