ccc909/Whistler/firmware/mic_aggregator/src/app_config.h

// Copyright 2023-2026 XMOS LIMITED.
// This Software is subject to the terms of the XMOS Public Licence: Version 1. Modified for the Whistler board, 2026-06-20 and 2026-10-23 (see firmware/README.md).

// This file contains general app configuration. For USB config, please see xua_conf.h

#pragma once

#define MIC_ARRAY_CONFIG_MCLK_FREQ          24576000
#define MIC_ARRAY_CONFIG_PDM_FREQ           3072000
#define MIC_ARRAY_CONFIG_USE_DDR            1
#define MIC_ARRAY_CONFIG_PORT_MCLK          XS1_PORT_1D // Whistler X1D11 - app-PLL MCLK loopback (tile[1])
#define MIC_ARRAY_CONFIG_PORT_PDM_CLK       XS1_PORT_1F // Whistler X1D13 = pin 64 (datasheet XM014532A)
#define MIC_ARRAY_CONFIG_PORT_PDM_DATA      XS1_PORT_8B // Whistler X1D14..X1D21 = 16 mics DDR
#define MIC_ARRAY_CONFIG_MIC_COUNT          16          // Application is currently hard coded to 16
#define MIC_ARRAY_CONFIG_SAMPLES_PER_FRAME  1           // Application is currently hard coded to 1
#define MIC_ARRAY_NUM_DECIMATOR_TASKS       3           // Defines the number of subtasks to perform the decimation process on.
#define MIC_ARRAY_PDM_RX_OWN_THREAD         1           // Use dedicated thread for PDM Rx task
#define MIC_ARRAY_CLK1                      XS1_CLKBLK_1
#define MIC_ARRAY_CLK2                      XS1_CLKBLK_2

#define TDM_SLAVEPORT_OUT                   XS1_PORT_1A // X1D00, I2S DAC OUT
#define TDM_SLAVEPORT_FSYNCH                XS1_PORT_1B // X1D01, I2S LRCLK
#define TDM_SLAVEPORT_BCLK                  XS1_PORT_1C // X1D10, I2S BCLK
#define TDM_SLAVEPORT_CLK_BLK               XS1_CLKBLK_1
#define TDM_SLAVETX_OFFSET                  1           // How many BCLK cycles after FSYNCH rising edge data is driver
#define TDM_SLAVESAMPLE_MODE                I2S_SLAVE_SAMPLE_ON_BCLK_RISING

#define TDM_SIMPLE_MASTER_FSYNCH            XS1_PORT_1M // X1D36, J10 - pin 2, '36'
#define TDM_SIMPLE_MASTER_DATA              XS1_PORT_1O // X1D38, J10 - pin 15, '38'
#define TDM_SIMPLE_MASTER_CLK_BLK           XS1_CLKBLK_2

#define I2C_CONTROL_SLAVE_ADDRESS           0x3c    
#define I2C_CONTROL_NUM_REGISTERS           (MIC_ARRAY_CONFIG_MIC_COUNT * 2) // Number of 8b registers. Each gain is 16b Little Endian (MSB @ 0, LSB @ 1)
#define I2C_CONTROL_SLAVE_SCL               XS1_PORT_1N //X0D37, SCL
#define I2C_CONTROL_SLAVE_SDA               XS1_PORT_1O //X0D38, SDA

#define MIC_GAIN_INIT                       100         // Allowed values 0 to 65535

#define USB_MCLK_COUNT_CLK_BLK              XS1_CLKBLK_4 // WHISTLER: not 3 - lib_xua's DFU flash lib owns CLKBLK_3 on tile[0]
#define USB_MCLK_IN                         XS1_PORT_1D // X1D11, I2S MCLK


// Configuration checks
#if MIC_ARRAY_CONFIG_MIC_COUNT > 8 && MIC_ARRAY_NUM_DECIMATOR_TASKS < 2
#error "MIC_ARRAY_NUM_DECIMATOR_TASKS: Unsupported value"
#endif

#if !(MIC_ARRAY_CONFIG_MIC_COUNT == 8 || MIC_ARRAY_CONFIG_MIC_COUNT == 16)
#error "MIC_ARRAY_CONFIG_MIC_COUNT: Unsupported value"
#endif

#if MIC_ARRAY_NUM_DECIMATOR_TASKS > MIC_ARRAY_CONFIG_MIC_COUNT
#error "MIC_ARRAY_NUM_DECIMATOR_TASKS must be less than or equal to MIC_ARRAY_CONFIG_MIC_COUNT"
#endif

#if MIC_ARRAY_CONFIG_USE_DDR != 1
#error "MIC_ARRAY_CONFIG_USE_DDR: This application only supports DDR"
#endif

#define NUM_DECIMATOR_SUBTASKS MIC_ARRAY_NUM_DECIMATOR_TASKS
