ccc909/Whistler/(commit log)

2026-10-23 Initial release: Whistler 16-channel USB MEMS microphone array
    - mic-array/ and motherboard/: KiCad 10 projects with production files
    (gerbers + drill zip, BOM with LCSC numbers, JLCPCB CPL, schematic PDF,
    STEP model).
    - lib/: packed Whistler symbol, footprint and 3D model library used by
    both boards, with a provenance note
    - firmware/: XU316 16-channel USB Audio Class 2 microphone firmware with
    USB DFU updates (prebuilt .xe and source), derived from XMOS sln_voice
    under the XMOS Public Licence v1
    - docs/: board renders and manufacturing notes
    - LICENSE: CERN-OHL-S v2 for the hardware design
    - README.md: overview, key features, structure, quick start, licence
2026-10-25 Add measurements, demo animation, mic specs and BOM cost
    - README: animation of the array tracking a 3 kHz tone carried around it,
    the 125 m whistle field test, microphone datasheet figures and per-board
    BOM cost at LCSC prices
    - docs/measurements.md: signal chain gain, geometry, channel map and sync,
    direction finding, noise floor, outdoor whistle test and headroom
    - docs/manufacturing.md: stock note for the XU316 and the QSPI flash
2026-10-25 Add per-part prices to the README BOM cost table
    Collapsible per-part tables for each board, with the cost per board at 1, 10
    and 100 boards (LCSC prices on 2026-10-25), adding up to the summary table.
